realWalter05/automated_chess/docs/latex/images/sachyVzhled.jpg

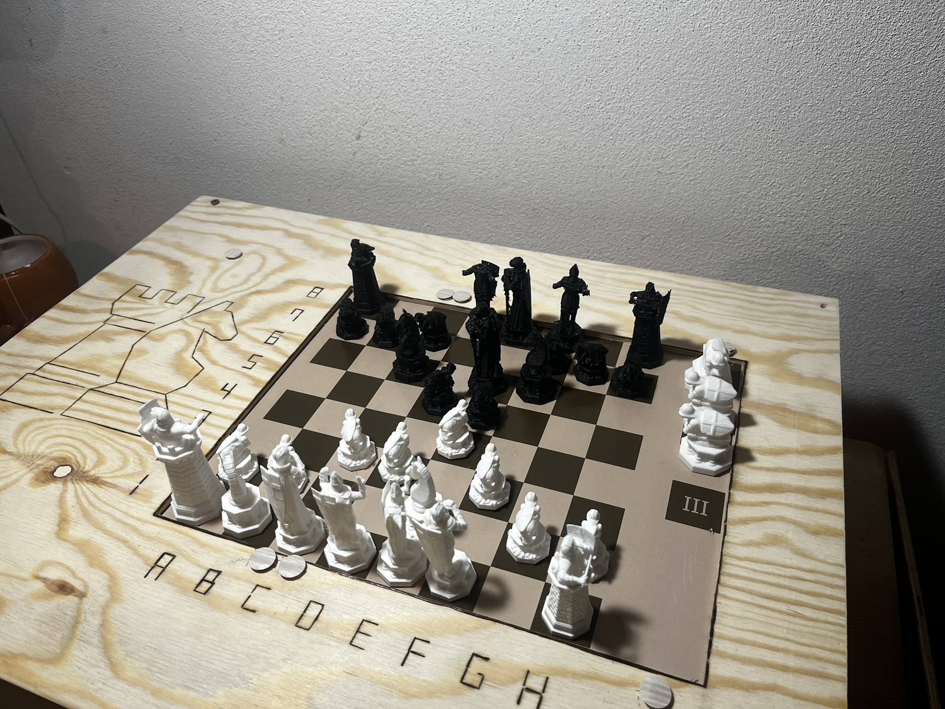
docs/latex/images/sachyVzhled.jpg
