realWalter05/automated_chess/docs/latex/images/pcbDesky.jpg

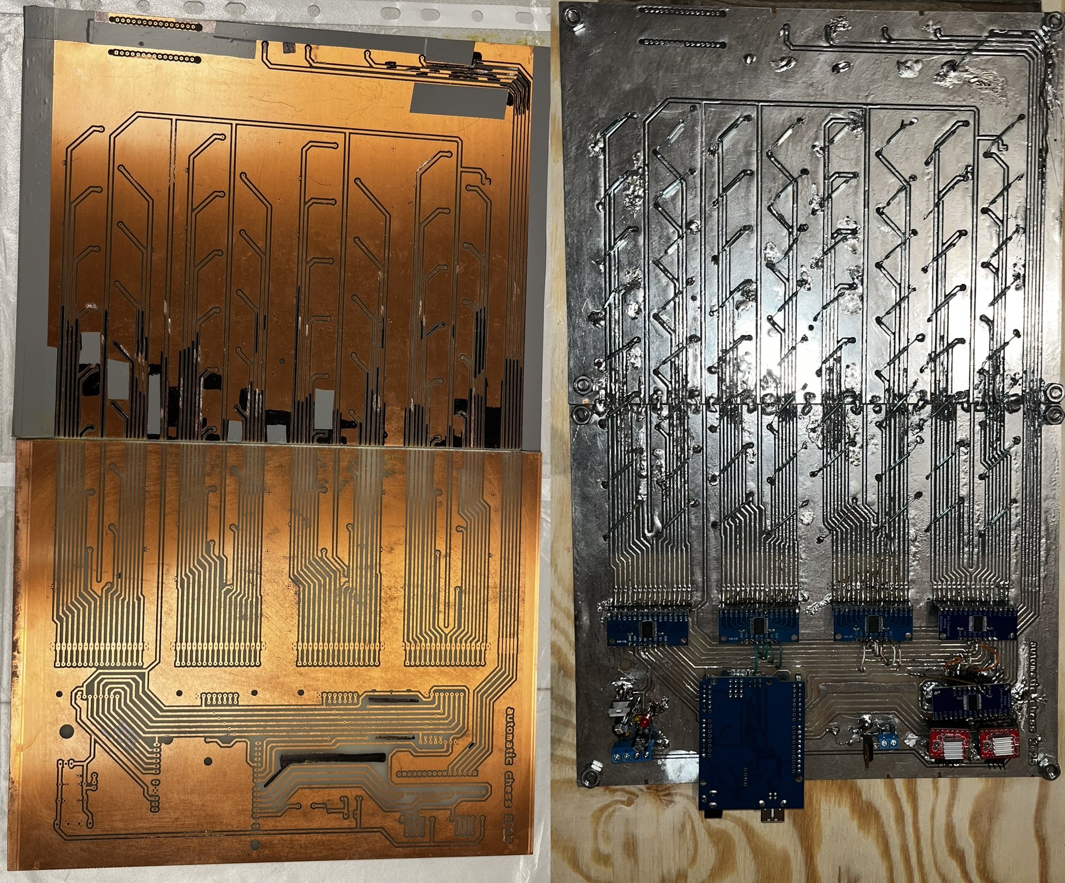
docs/latex/images/pcbDesky.jpg
