realWalter05/automated_chess/docs/latex/document.tex

\documentclass[a4paper, 12pt]{report}
\usepackage{monapack}
\usepackage{xcolor}
\usepackage{listings}

\definecolor{mGreen}{rgb}{0,0.6,0}
\definecolor{mGray}{rgb}{0.5,0.5,0.5}
\definecolor{mPurple}{rgb}{0.58,0,0.82}
\definecolor{backgroundColour}{rgb}{0.95,0.95,0.92}

\lstdefinestyle{CStyle}{
	backgroundcolor=\color{backgroundColour},   
	commentstyle=\color{mGreen},
	keywordstyle=\color{magenta},
	numberstyle=\tiny\color{mGray},
	stringstyle=\color{mPurple},
	basicstyle=\footnotesize,
	breakatwhitespace=false,         
	breaklines=true,                 
	captionpos=b,                    
	keepspaces=true,                 
	numbers=left,                    
	numbersep=5pt,                  
	showspaces=false,                
	showstringspaces=false,
	showtabs=false,                 
	tabsize=2,
	language=C
}

\student{Václav Zíka}
\trida{B4.I}
\obor{18-20-M/01 Informační technologie}
\bydliste{Na Spravedlnosti 974/36, Písek 39701, Česká republika}
\datumNarozeni{29. 12. 2005}
\vedouci{Mgr. Milan Janoušek}
\nazevPrace{Elektromechanická hra -> samořídící\,šachovnice}
\cisloPrace{4.}
\skolniRok{2024/2025}
\reditel{Ing. Jiří Uhlík}

\zacatek

\titulniStrana

\licencniSmlouva{31. 3. 2025}

\anotace 
Maturitní práce se zabývala tvorbou samořídící šachovnice, jejíž cílem bylo kompletně simulovat protihráče.
Ať už se jedná o vymýšlení protitahu či o samotný manuální posun figurky. Šachovnice je ovládána mikrokontrolérem
Arduino~UNO. Pomocí magnetických spínačů umístěných na PCB detekujeme pozici figurek na hracím poli. Tyto informace
následně zpracováváme Arduinem a skrze dva krokové motory a elektromagnet realizujeme tahy figurek. Pro zjištění
ideálního příštího tahu využíváme MiniMax algoritmus, jenž je schopný zevaluovat danou situaci a skrze programovou
logiku udat příkazy pro pohyb figurek. Celá samořídící šachovnice je vyrobena z dřevěné konstrukce, do které je
umístěna deska plošného spoje s elektronikou. Šachové figurky použité v projektu jsou vytvořené pomocí 3D tisku.  \\
\tucne{Klíčová slova:} Samořídící šachovnice, automatizace, programové řízení

\annotation
Graduation thesis focuses on construction of self-controlling chessbord. The goal of the work is to completely simulate opponent. within the simulation, we should be able to come up with ideal counter move and manual movement of the piece. The chessboard is controlled by a microcontroller Arduino UNO. We use reed switches situated on a PCB to detect position of chess pieces. These information we proccess with Arduino and through two stepper motors and an electromagnet we realize moves. To detect ideal next move we use MiniMax algorithm, which is able to evaluate given situation and through program logic set signals for stepper motors. The self-controlling chessboard is made out of wooden construction inside which is installed printed circuit board with neccessary electronics. Chess pieces used in project have been made by 3D print. \\
\tucne{Key words:} Self-controlling chessboard, automatization, program control

\podekovani
Chtěl bych poděkovat panu Mgr. Janouškovi za podporu a vedení práce. Za jeho odborné rady a konzultace ohledně možných řešení. Také bych chtěl vyjádřit dík panu Táborovi, Kutilovi, Kolpovi a panu Vondrákovi.

\obsah

\kapitola{Úvod}
Nápad pro automatickou šachovnici jsem dostal při hledání nového projektu,
který bych si doma zvládl sestrojit. Chtěl jsem, aby projekt obsahoval, jak 
část softwarovou, kterou jsem se do té doby primárně zabýval, tak i část 
mechanickou, kterou by bylo nutné vyrobit. 

Napadlo mě vytvořit nějakou deskovou hru pro více hračů. V té době jsem měl
ve velké oblibě šachy, a proto vznikla idea automatické šachovnice. Začal jsem nákresem
na papír a tím jsem získal základní představu o projektu. Šachovnice by se skládala ze tří
hlavních částí:

\popisseznam{
	\polozka {Konstrukční část} {
		Konstrukční část se skládá ze samotné dřevěné konstrukce šachovnice, do které bude nutné umístít mechanismus
		pro pohybování s figurkami. V rámci toho také její opracování a  nadesignování projektu. 
		Tvorba šachových políček a rozhraní pro jednoduché ovládání.
	}
	\polozka {Elektrotechnická část}{
		Ta obsahuje systém pro detekci figurek na šachovnici. Ten by se dal vytvořit pomocí mnoha
		způsobů, ale v práci budu popisovat řešení pomocí desky plošného spoje. Dále vytvoření pohybové 
		soustavy pomocí krokových motorů a umístění elektromagnetu, který bude s figurkami pohybovat. Posledním
		krokem je sestrojení systému, který dovolí hráči nastavit jakou obtížnost bude mít oponent.
	}
	\polozka {Softwarová část}{
		Z hlediska softwaru je nutné vytvořit kód, který spojí všechny části dohromady. Je nutné transformovat
		signály tak, aby s nimi bylo možné pracovat. Z hlediska kódu je nutné vytvořit rozhraní pro komunikaci
		mezi mikrokontrolérem a součástkami. Je zapotřebí umožnit evaluaci dat o pozicích figurek a předat je
		algoritmu, který nám bude schopen vymyslet další tah. 
	}
}

\kapitola{Teoretická část}
V této kapitole si popíšeme technologie, které byly zapotřebí při tvorbě projektu.
Získáme k nim teoretický základ nutný k porozumění šachovnice.

\podkapitola{Arduino}
Arduino je platforma pro tvorbu různých elektronických projektů. Zabývá se 
hardwarem a softwarem a obě tyto části vytváří jako open-source. To je jeden
z důvodů velkého rozšíření mikrokontrolerů Arduino. 

Mikrokontrolér Arduino je malý počítač založen na jednom čipu. Arduino vyrábí
mnoho různých řad jejich projektů, ale mezi nejznámější se řadí Arduino UNO či
Mega. Arduino desky na sobě mají široké spektrum možných vstupů, výstupů a senzorů.
Velkou výhodou těchto desek je cena. Ta se pohybuje v řádech stovek korun.

Arduino desky se primárně programují pomocí platformy Arduino IDE. To je další open-source
program, který má na základě popularity mezi lidmi i velkou podporu knihoven
s různými zaměřeními.

\podkapitola{Deska plošného spoje}
PCB deska, jak je zkratkou nazývána, nebo také DPS je velmi rozšířená elektronická součástka.
Desky jsou vyrobené z izolačních materiálů s pájecími poli, kterým se říká podložky a elektrickými spoji nazývanými stopy.
Na PCB desky se připájí potřebné součástky. Tyto součástky jsou spolu pak propojeny na základě schématu pro tvorbu PCB. Jsou dvě primární technologie 
montáže součástek na desku. Je tady technologie průchozích otvorů (THT, Through-Hole Technology), nebo povrchové montáže (SMD, Surface-Mounted Devices) \viz{pcb_SMT_THT}. Při povrchové montáži se napájí součástky přímo na desku s tím, že jsou na ní připravené jednotlivé stopy. U THT jsou v desce připravené otvory, do kterých součástky umísťujeme.
\obrazek{pcb_SMT_THT}{Rozlišení SMT a THT na PCB desce}{12cm}{pcb_SMT_THT.png} 

\podkapitola{Elektronické součástky}
\podpodkapitola{Magnetický spínač}
Tento typ spínače je elektronický obvod aktivovaný pomocí magntického pole. Nejběžnější je konstrukce pomocí dvou feromagnetických kovů umístěných kousek od sebe ve skleněné kapsli. V momentě, kdy je ke spínači přiložen magnet se kovy spojí a začnou vodit. Magnetické spínače jsou například využívány pro detekci uzavření dveří. 

\podpodkapitola{Multiplexor}
Tato elektronická součástka slouží k přepínání vstupů na jeden výstup na základě řídících signálů. Multiplexor je realizován integrovanými obvody. Pomocí této součástky jsme napřílad schopni zvětšit počet vstupů na určitém zařízení o počet vstupů na multiplexoru, s tím že do zařízení zapojíme pouze multiplexor. Tento postup je ideální v momentě, kdy máme zařízení s nedostatkem vstupů pro dané využití.

\podpodkapitola{Stabilizátor}
Stabilizátor nám zajištuje výstupní nápětí bez ohledu na změny výstupního proudu či vstupního napětí. Stabilázátory se dělí na lineární paremetrický, lineární zpětnovazební a spínací zpětnovazební. Stabilizátory fungují na principu regulace odporu pomocí tranzistoru na základě referečního napětí a napětí žádaného. Ke stabilizátoru se přidávají kondenzátory, které eliminují šum a stabilizují výstup. Lineární stabilizátory regulují napětí, tím že fungují jako proměnný odpor mezi vstupem a výstupem. 

\podpodkapitola{Elektromagnet}
Elektromagnetem se rozumí cívka pomocí, které jsme schopni vytvořit dočasné magnetické pole. Jádro této cívky je z magneticky měkké oceli. V momentě, kdy začneme cívkou vést proud, začne se okolo ní vytvářet magnetické pole. Velikost a polaritu tohoto pole jsme schopni ovládat.

\podpodkapitola{Krokový motor}
Krokový motor je zařízení, které nám dovolí na základě elektromagnetických pulsů přesně rotovat. V motoru je ozubené kolo, které můžeme otáčet na základě polových dvojic. Pomocí pulsování jednotlivá pole přitáhnou ozubené kolo a na základě tohoto jevu, můžeme motor otočit o přesný počet kroků. Rychlost rotování jsme schopni korigovat na základě změn frekvence aktivace polí. To realizujeme skrze ovladače krokových motorů.

\podkapitola{Mini-Max algoritmus}
Tento typ algorithmu je fundamentálním konceptem umělé inteligence a teorie her. Mini-Max má za cíl zminimalizovat možnou ztrátu na základě analýzy nejhorších možných scénářů, neboli min, a těch nejlepších, max. Ve hře pro dva hráče si algoritmus vytvoří dvě interní entity. Ta první se jmenuje Maximizer a cílí získat nejvyšší možné skóre. Oproti ní druhá, Minimizer, má za cíl, co nejvíce skóre Maximizer snížit. Toho docílí tak, že evaluuje všechny možné tahy obou hráčů zároveň.\clearpage\obrazek{minimax}{Minimax algoritmus}{10cm}{minimax.png}

Z počátku si Mini-Max vytvoří tzv. herní strom. Účelem tohoto stromu je reprezentovat všechny možné tahy, které mohou v daný moment ve hře nastat. Dalším krokem je, že u tzv. závěrečných stavů (terminal nodes) určí skóre. Skoŕe se určuje na základě kritérií daných v kódu a postupně ve stromu postupuje výše a určuje skóre dál. Poté, co Mini-Max určí skóre pro všechny možné stavy, projde jednotlivé scénáře. V kole Maximizera volí variantu s nejvyšším možným skórem. Naopak v kole minimizera tu s nejnižším. Podle nejvyššího možného celkového skóre algoritmus určí příští zvolený blok.

\kapitola{Praktická část}

\podkapitola{Elektrické zapojení}
Pro projekt bylo zapotřebí vymyslet efektivní a spolehlivý způsob propojení. Zároveň však způsob nesměl bránit detekci figurek pomocí spínačů. Nabízela se spoustu možností, ale z důvodů velkého množství součástek jsem se rozhodl pro dle mě nejčistčí řešení, a to desku plošného spoje. 

\podpodkapitola{PCB deska}
Deska plošného spoje bylo řešením, které se nabízelo kvůli spolehlivosti a zároveň tím, že deska je velmi tenká  a její materiál nijak nebrání průchodu magnetického pole. Na základě mého schématu v programu EasyADA jsem si desku nechal sestrojit. Schéma šachovnice najdete v přílohách pod názvem schema\_sachovnice.pdf. Z důvodu výrobních možností a rozměrů desky byla deska sestrojena na dvě poloviny. Tyto poloviny jsem spájel dohromady. Deska byla vyrobena technologií SMT, takže jsem na ní povrchově připájel piny pro všechny potřebné součástky. A to:
\bodseznam{
	\bod 69 jazýčkových magnetických kontaktů
	\bod 5 analogových multiplexorů, transistor a různé drobné zařízení
	\bod Mikrokontroler Arduino UNO
	\bod Dva A4988 ovladače pro krokové motory
	\bod Stabilizátor a piny pro vstupní napětí
	\bod Napájení pro motory a elektromagnety
}
\clearpage\obrazek{pcb_porovnani}{Porovnání PCB desky z výroby a osázené}{16cm}{pcbDesky.jpg}
Desku jsem si následně nechal pocínovat. Dvě části jsem pomocí propojek spojil dohromady. Během práce jsem posléze při detekci figurek musel řešit velký problém, a to se spolehlivostí desky. Magnetické spínače nefungovaly spolehlivě. Důvodem byly narušené cesty a také křekhost spínačů. Ty během pájení velmi snadno praskly.

Tyto problémy jsem řešil za pomocí multimetru a posléze detekcí pomocí počítače. Na desce jsem postupně zkontroloval všechny cesty a v momentě, kdy špatně vodily jsem na ně napájel vrstvu cínu. Pokud problém spočíval v propojení dvou vedlejších cest, vzal jsem nůž a cín manuálně odstranil. Největším úśkalím bylo manuální propojení dvou desek dohromady. Tato část desky vyžadovala časově velmi úpornou manuální péči.

Desky se mi po opravách podařilo dostat do spolehlivého stavu. Jednou věcí, která mi však projekt stížila bylo, že nespolehlivost cest na desce a spínačů jsem objevil až v momentě, kdy jsem programoval detekci figurek. V tuto chvíli jsem však již, alespoň mohl využít napojení na multiplexory a pomocí kódu je kontrolovat skrze konzoly na počítači. To usnadilo proces oprav.

Deska je napájena externím 18V zdrojem. Na desce se pomocí stabilizátoru pro většinu součástek nastaví napětí 5V, avšak pro motory a elektromagnet zůstává napětí 18V.

\podpodkapitola{Výběr řídící jednotky}
Mikrokontrolér, který jsem si vybral pro samořídící šachovnici je Arduino UNO. Toto Arduino splňovalo veškeré nutné požadavky pro ovládání a zároveň to byl mikrokontroler, který jsem měl z počátku projektu doma a mohl jsem na něm zprvu testovat. Arduino je napájeno 5V z PCB desky a ovládá celou šachovnici. Arduino je naprogramováno variantou jazyku C++, ale o tom budu psát podrobněji později v práci. Do mikrokontroleru jsou skrze multiplexory zapojeny všechny magnetické spínače. Arduino si pomocí programové logiky přepíná jaký z multiplexorů bude v dané chvíli aktivní, jelikož data multiplexorů proudí po stejných cestách. Dále jsou do Arduina zapojené drivery motorů a transistor, který slouží k ovládání elektromagnetu.

\podkapitola{Detekce obsazenosti políček}	
V této kapitole popíši, na jakém principu se v šachovnici detekují pozice figurek. Vysvětlím jednotlivé zapojení multiplexorů a kód, který je ovládá. Spolehlivé detekování pozice figurek je stěžejním bodem této práce, jelikož z něho vychází další operace projektu.

\podpodkapitola{Zapojení a princip}
Aby samořídící šachovnice fungovala je zapotřebí vědět pozici figurek na herním poli. Nabízí se dvě řešení. Detekce pomocí kamer a zpracování obrazu a pomocí magnetických spínačů. Řešení pomocí kamer jsem zavrhl, jelikož by to znamenalo nějaké rameno na šachovnici s kamerou. To mi nepřipadalo ideální. Magnetické spínače nám zachovají čistý vzhled šachovnice. Jelikož však na šachovnici máme 64 políček, potřebujeme 64 spínačů. Tolika piny naše Arduino Uno nedisponuje, a tak je zapotřebí využít nějaký systém pomocí, kterého počet vstupů snížíme. 

Po průzkumu a práci na řešení jsem se inspiroval z jednoho projektu dostupného na internetu \citace{Projekt automatické šachovnice}. V tomto projektu bylo využito multiplexorové řešení. Zapojíme piny spínačů do multiplexoru, a ten pak čteme pomocí řídící jednotky. Pomocí tohoto postupu jsme schopni zredukovat 64 pinů na 4 multiplexory. V této práci jsem jich využil pět, jelikož poslední multiplexor se stará o volbu obtížností a barvy.
\clearpage\obrazek{spinaceSchema}{Zapojení magnetických spínačů na desce}{16cm}{spinaceSachovnice.png} 

Multiplexory, které jsem využil mají 16 datových vstupů, 4 vstupy adresové, nápajení, zem, zapínací pin EN a výstup SIG. Výstupy multiplexorů, jak je vidět na schématu \viz{spinaceSchema}, jsou zapojeny do stejných cest na PCB desce. Stejně tak výstup SIG je pro všechny multiplexory stejný. Toto není problém, jelikož v kódu využivám pin Enable (en). Jestliže je tento pin v logické jedničce, je multiplexor vypnutý. V momentě, kdy je v logické nule, je zapnutý. Na základě tohoto principu jsme schopni přepínat přepínače samotné a tím ještě více zminimalizovat počet nutných vstupů do Arduina UNO.

\podpodkapitola{Programový kód}
Jak už jsme zmínili, šachovnice je ovládána mikrokontrolerem Arduino UNO, jenž se programuje variantou C++. Kód pro ovládání multiplexorů nám musí zajistit jejich přepínání pomocí Enable pin a stabilní detekci pozic. První věc, kterou musíme v kódu nastavit jsou Enable piny. Po zapnutí nastavím Enable pin jako OUTPUT a pomocí for loopu si procyklujeme všechny Enable piny multiplexorů a dáme na ně logickou jedničku. Tato část kódu je v setup() funkci kódu. Ta se spustí pouze po spuštění mikrokontroleru.
\begin{lstlisting}[style=CStyle]
// Disabling Multiplexers  (When high - does nothing)
for (int i = 0; i < 5; i++) {
	pinMode(muxEnable[i], OUTPUT);
	digitalWrite(muxEnable[i], HIGH);
}

for (int i = 0; i < 4; i++) {
	pinMode(muxAddr[i], OUTPUT);
	digitalWrite(muxAddr[i], LOW);
}
\end{lstlisting}

\podpodpodkapitola{Čtení hodnot pomocí getReedValues()}
Pro čtení hodnot využíváme funkci getReedValues. V ní nejprve zaktivujeme multiplexor tím, že mu nastavíme pin na 0. Poté začneme na jeho adresové piny vysílat binarní kombinace od 0 do 15. Toho docíleme opět pomocí for cyklu a využití modulo funkce (v kódu jako \%). Data následně ukládáme do našeho interního variablu muxValues a poté, co deaktivujeme multiplexor a jeho adresové vstupy, překopírujeme pomocí funkce memcpy hodnoty do proměnné recordedReedValue. Ta nám slouží pouze pro ukládání nejnovější možné detekce pozic. Pozice každé druhé řady zapisujeme oproti řadě první obráceně. To je z důvodu zapojení na PCB desce a realizováno podmínkou ve funkci.

\begin{lstlisting}[style=CStyle]
void getReedValues(int targetMuxAddress, int from, int to) {
	// Splitting to two rows because row of chessboard has 8 pieces
	int muxValues[8];
	
	// Activating MUX
	digitalWrite(targetMuxAddress, LOW);
	for (int j = from; j < to; j++) {
		// Checking MUX combinations
		digitalWrite(muxAddr[0], j % 2);
		digitalWrite(muxAddr[1], j / 2 % 2);
		digitalWrite(muxAddr[2], j / 4 % 2);
		digitalWrite(muxAddr[3], j / 8 % 2);
		
		int reedValue = digitalRead(muxOutput);
		
		if (j > 7) {
			muxValues[j - 8] = reedValue;
		} else {
			muxValues[to - j - 1] = reedValue;
		}
	}
	// Resetting MUX
	digitalWrite(muxAddr[0], LOW);
	digitalWrite(muxAddr[1], LOW);
	digitalWrite(muxAddr[2], LOW);
	digitalWrite(muxAddr[3], LOW);
	
	digitalWrite(targetMuxAddress, HIGH);
	memcpy(recordedReedValue, muxValues, sizeof(recordedReedValue));
}
\end{lstlisting}

Jelikož je SIG pin multiplexorů nastavený jako INPUT\_PULLUP, což je nutné pro detekci zda spínač spíná zem či je rozpojený, dostávám všechny rozpojené spínače jako jedničky. Ty seplé jako nuly. Ve výsledku může výstup v konzoli po zahájení hry vypadat takto.
\clearpage
\begin{center}
\strojopis{\\
8 - 0 0 0 0 0 0 0 0\\
7 - 0 0 0 0 0 0 0 0\\
6 - 1 1 1 1 1 1 1 1\\
5 - 1 1 1 1 1 1 1 1\\
4 - 1 1 1 1 1 1 1 1\\
3 - 1 1 1 1 1 1 1 1\\
2 - 0 0 0 0 0 0 0 0\\
1 - 0 0 0 0 0 0 0 0\\
-------A B C D E F G H
}
\end{center}

\podpodpodkapitola{Ukládání všech pozic}
Předchozí funkce nám zajištuje přečtení hodnot multiplexoru na základě daných parametrů. V kódu máme další pomocnou funkci setCurrentBoard(). Cílem této funkce je projít všechny řady šachovnice od první až po osmou a uložit je do mikrokontroleru. V mikrokontroleru je opět pomocí funkce memcpy překopíruje do dvouřadého listu boardValues, který obsahuje všechny pozice figurek.
\begin{lstlisting}[style=CStyle]
void setCurrentBoard() {
	getReedValues(muxEnable[0], 0, 8);
	memcpy(boardValues[0], recordedReedValue, sizeof(boardValues[0]));
	
	getReedValues(muxEnable[0], 8, 16);
	memcpy(boardValues[1], recordedReedValue, sizeof(boardValues[1]));
	//.....another five reads
	getReedValues(muxEnable[3], 8, 16);
	memcpy(boardValues[7], recordedReedValue, sizeof(boardValues[7]));
\end{lstlisting}

\podpodpodkapitola{Detekce přemístění figurek}
Předchozí funkce v této kapitole nám vysvětlují, jak šachovnice data čte. Nadcházející funkce je však zodpovědná za samotnou detekci změny pozic, při kterých uživatel vezme figurku do ruky a přendá ji na jiné políčko. Tato funkce je napsána bloku loop(). To je opět platformou Arduino daná funkce, která se po spuštění již zmíněné funkce setup() neustále opakuje.

Abychom zjistili, zda se událo přemístění figurky musíme pravidelně číst pozice hodnot a porovnávat je z přechozími. To děláme pomocí while cyklu, který se opakuje do doby, než jsou splněné podmínky uvedené v závorkách. Podmínky, které jsou v kódu nastavené vyžadují, aby list proměnných move obsahoval čtyři hodnoty. Neboli hodnotu čísla a písmena odkud se figurka přemístila a hodnoty kam. Jak zjistíme hodnoty, které ukládáme do move, vysvětlím dále v textu. Nejprve tedy uložíme hodnoty pozic do proměnné boardValuesMemory a následně přejdeme do cyklu. V tomto cyklu se neustále volá funkce detectBoardMovement() až do splnění zmíněných podmínek.
\begin{lstlisting}[style=CStyle]
	// Player's turn => waiting for movement
	setCurrentBoard();
	memcpy(boardValuesMemory, boardValues, sizeof(boardValuesMemory));
	while (!move[0] || !move[1] || !move[2] || !move[3]) {
		detectBoardMovement();
	}
\end{lstlisting}

\podpodpodkapitola{Funkce detectBoardMovement()}
Pomocí této funkce detekujeme, zda bylo uskutečněno přemístění figurek. Tato funkce je volána cyklicky z while loopu dokud nenajdeme čtyři hodnoty pro proměnnou move. Např. e2e4 by nám značilo pohyb z počátku hry pěšče o dvě místa z e2 na políčko e4. Funkce porovnává současné hodnoty pozic v proměnné boardValues, které nastaví pomocí funkce setCurrentBoard() s hodnoty boardValuesMemory  uloženými v hlavním cyklu před zahájením while cyklu. 

\begin{lstlisting}[style=CStyle]
void detectBoardMovement() {
	bool fromChange = false;
	setCurrentBoard();

	for (int i = 0; i < 8; i++) {
		for (int j = 0; j < 8; j++) {
			if (boardValuesMemory[i][j] != boardValues[i][j] && boardValues[i][j]) {
				// Position of piece has changed
				delay(1000);
				setCurrentBoard();
				if (boardValues[i][j]) {
					// Piece was here before
					fromChange = true;
					move[0] = letterTranslate[j];
					move[1] = numberTranslate[i];
				}
			}
		}
	}

	// For loop for 1-0...

	if (!fromChange || (move[2] && !move[0])) {
		setCurrentBoard();
		memcpy(boardValuesMemory, boardValues, sizeof(boardValuesMemory));
		resetMove();
	}
	delay(1000);
}
\end{lstlisting}
Funkce pomocí for loopu prochází hodnoty pozic a tam postupně porovnává každé políčko s každým dokud nenajde nějakou změnu. V případě, že všechny hodnoty jsou stejné jako předtím, funkce se s vteřinovým zpožděním spustí znovu. V případě změny však pomocí kódu detekujeme zda šlo o změnu z 0 na 1 či naopak. 

\popisseznam{
	\polozka {Změny z 0 na 1}{Jelikož logická jednička označuje prázdné políčko, tato zmena značí odkud se figurka přemístila. Zapíše se tedy do move na první a druhé pozici.}
	\polozka {Změny z 1 na 0}{Značí, že políčko bylo dříve prázdné a nyní se na něj umístila nová figurka. Zapíše se tedy do list move na třetí a čtvrtou pozici}
}

V momentě, kdy naplníme všechny čtyři místa v listu move, zruší se while cyklus v hlavní funkci programu a kód může postupovat dále. Ve funkci na konci kontrolujeme situaci, kdy se projde celý cyklus a najde pouze pozici, kam se figurka přemístila ale ne odkud. Také hlídáme situaci, kdy se žadný tah nenajde. V takových případech, tah resetujeme a nastavíme novou hodnotu pozic spínačů do boardValuesMemory. Poté je ve funkci vteřinové zpoždění, které zajištuje větší spolehlivost detekce při přesunu figurek.

\podkapitola{Pohyb figurek na hracím poli}
Realizaci šachových tahů nám zajištují dva krokové motory a elektromagnet. Pro účel práce bylo nutné umožnit XY pohyb elektromagnetu uvnitř šachovnice. Soustavu bylo nutné umístit dovnitř konstrukce a zajistit, aby byl elektromagnet velmi blízko PCB desce a tím i figurkám.

\podpodkapitola{Elektromagnet}
Samotné přemístění figurky je realizováno pomocí elektromagnetu. Ten po přivedení proudu vytvoří elektromagnetické pole, které začne působit na magnetickou šachovou figurku nad ním, a tím s ní můžeme hýbat. Během tvorby řešení jsem musel zajistit, aby elektromagnetické pole nebylo příliš velké a neovlivňovalo ostatní figurky. Zprvu ovšem nastal jiný problém. Elektromagnet, i když zapnutý, nebyl schopen figurkou pohnout. Tato situace nastala na základě faktu, že pro velkou účinost elektromagnetu je nutné zminimalizovat prostor mezi elektromagnetem a přitahovaným tělesem. V situaci, kdy jsem používal elektromagnet se silou 150N stále to nebylo dostatečné. Problém jsem vyřešil vyvýšením elektromagnetu v konstrukci a zasazením jej blíže k plošnému spoji. Po těchto úpravách mi postačil, elektromagnet se silou 50N. Avšak ani tento elektromagnet by s figurkami nepohnul, jestliže by do nich nebyly umístěné magnetické prvky. Pokud bu do figurky byla umístěna prostá ocel, nedokázal by jí elektromagnet přemístit.

Elektromagnet, který v práci využívám je v paremetrech u prodejce uváděn na 12V. Já do něj však vysílám 18V z důvodu lepší spolehlivosti. Abychom však elektromagnet mohli ovládat, musel jsem vymyslet způsob, jakým do elektromagnetu těchto 18V budu vpouštět pouze po zaslání signálů. Na to využivám transistor. Transistor použitý v práci po přivedení signálu na bázi, přepne vstup z kolektoru na emitor. Na kolektoru mám přivedenou zem a po zaslání signálů na bázi, vyšlu zem skrze emitor do elektromagnetu. Ten je z jeho druhého vstupu připojen k napětí a po přivedení země, začne působit. Po ukončení signálu na bázi se elektromagnet vypne.\obrazek{transistor}{Ovládání elektromagnetu pomocí transistoru}{8cm}{transistor.png} 

Kód, který transistor ovládá je velmi jednoduchý. Ve fuknci makeMove, o které budu v dalších kapitolách hovořit, je boolovská proměnná magnetActivated. V případě, že magnet potřebuji, nastavím jí jako true a pomocí podmínky v této funkci vyšlu na pin báze transistoru (magnetPin) logickou jedničku. Na konci funkce  po provedení pohyby, magnet vždy vypínám.
\begin{lstlisting}[style=CStyle]
	// Enabling the electromagnet if neccesary
	if (magnetActivated) {
		digitalWrite(magnetPin, HIGH);
	}
\end{lstlisting}

Dále je důležitá kalibrace elektromagnetu. Pro správný průběh programu je zapotřebí, aby elektromagnet byl vždy na začátku hry na stejném místě. Toto místo je mírně vedle pozici a1. Ke kalibraci využíváme funkci resetMagnet a setupMagnet. Přemístění provedeme, tak že po zapnutí samořídící šachovnice, umístíme na pozice ovládacích spínačů tři figury. Obsadíme pozice pro volbu hry za bílé, černé a první obtížnost.

\begin{lstlisting}[style=CStyle]
while (!controlValues[4] && !controlValues[5] && !controlValues[6]) {
	getReedValues(muxEnable[4], 0, 8);
	memcpy(controlValues, recordedReedValue, sizeof(controlValues));
	digitalWrite(dirPinX, LOW);	
	digitalWrite(stepPinX, HIGH);
	delayMicroseconds(motorDelay + 600);
	digitalWrite(stepPinX, LOW);
	delayMicroseconds(motorDelay + 600);
	magnetX = 1;
}
\end{lstlisting}

Kód začne přesouvat elektromagnet doleva až do doby, kdy odstraníme figury ze spínače pro obtížnost. Poté se začne elektromagnet přesouvat směrem dolů. Cílovou pozici poznáme pomocí zvuku, které motory při pohybu dodávájí. V momentě, kdy magnet dosáhne cílové ať už X či Y souřadnice, začne zvuk motoru zintenzivňovat. Elektromagnet eventuálně pomocí funkce setupMagnet, posuneme mírně směrem vpravo a tím zajistíme start na pozici a1.

\podpodkapitola{Krokové motory}
Pro zajištění pohybu využívám dva krokové motory NEMA17 s driverem A4988. Driver krokových motorů slouží jako mezikrok mezi programem a kódem a zajištuje pohodlné ovládání motorů. Do těchto driverů přivádím po desce, jak 18V, tak 5V. Dále na nich nastavujeme směr pohybu a vysíláme signály, pomocí kterých pak motor hýbe s konstrukcí. Pro zajištění správného pohybu bylo nutné zajistit dostačné napětí. To je dle specifikací 8 až 35V. Po otestovaní jsem zjistil, že 18V bylo pro projekt ideální. Abych zamezil přehřívání ovladačů, nalepil jsem na ně z vrchu chlazení, které je s nimi prodáváno.

\podpodpodkapitola{Konstrukce}
Konstrukce je realizována pomocí soustavy dvou motorů. Během řešení této problematiky jsem se inspiroval tímto projektem\citace{Projekt řízené šachovnice}. První motor je umístěn zevnitř boční stěny šachovnice. Na motor jsem umístil vhodnou řemenici a řemen natáhl na protější stěnu. Zde jsem si ze dřeva sestrojil ústrojí pro další řemenici. Pod řemenem vedou tři vodicí tyče, do kterých jsem umístil druhý motor s konstrukcí. Řemen prochází touto konstrukcí a při otáčení řemenice, tak pomocí řemenu pohybujeme na Y ose i s konstrukcí uvnitř šachovnice. Vnitřní konstrukce je umístěna na třech ložiscích, kterými prochází vodící tyčí. V této vnitřní dřevěné konstrukci je vyříznut otvor pro druhý krokový motor a zde je postupováno podle podobného postupu. Vedou zde dvě vodicí tyče na X ose. Na těchto vodicích tyčí jsou dvě ložiska, na která jsem si sestrojil dřevěnou plošinku připravenou pro umístění magnetu. Magnet je na plošině vyvýšen pro zajištění spolehlivého přenosu figurek a kabely jsou vyvedeny na PCB desku. Na druhé straně je opět ústrojí pro řemenice a řemen je proveden skrze plošinu s elektromagnetem.\clearpage\obrazek{konstrukceKrokovychMotoru}{Konstrukce krokových motorů}{14cm}{krokoveMotory.png} 

\podpodpodkapitola{Programový kód}
Funkci, která ovládá motory jsem nazval moveMagnet. Tato funkce bere tři vstupní parametry. Směr (direction) a vzdálenost (distance). Pro přehlednost nerozlišuje směry pomocí if podmínek, ale pomocí switche. V něm nastavím, jaký blok kódu se provede, jestliže směr bude odpovídat hodnotě za "case". Hodnota směru je dána jako pozice v numerické klávesnici. Tedy 4 jako pohyb vlevo, 2 pohyb směrem dolů a např. 9 jako diagonální pohyb doprava nahoru.
\begin{lstlisting}[style=CStyle]
void moveMagnet(int direction, int distance) {
	switch (direction) {
		//...
		case 4:
			// Left
			digitalWrite(dirPinX, LOW);
			for (int i = 0; i < boxLength * distance; i++) {
				digitalWrite(stepPinX, HIGH);
				delayMicroseconds(motorDelay);
				digitalWrite(stepPinX, LOW);
				delayMicroseconds(motorDelay);
			}
			magnetX = magnetX - distance;
		break;
		case 9:
			// Diagonal right up
			digitalWrite(dirPinY, HIGH);
			digitalWrite(dirPinX, HIGH);
			for (int i = 0; i < boxLength * distance; i++) {
				digitalWrite(stepPinY, HIGH);
				digitalWrite(stepPinX, HIGH);
				delayMicroseconds(motorDelay);
				digitalWrite(stepPinY, LOW);
				digitalWrite(stepPinX, LOW);
				delayMicroseconds(motorDelay);
			}
			magnetX = magnetX + distance;
			magnetY = magnetY + distance;
		break;
	}
//...
\end{lstlisting}
Samotný kód, který vysílá signály ovladači je v bloku pod case. Nejprve určíme směr pohybu. Buď logickou nulou či jedničkou. Následně začneme pomocí for cyklu vysílat pulzy do motoru. Vždy nejdříve aktivujeme nutný stepPin. Pak zahájíme prodlevu. Tato prodleva nám určuje rychlost otáčení. Čím menší je, tím rychleji se motory točí. Poté stepPin vypneme a znovu zahajíme prodlevu. Tento cyklus se opakuje podle žádané vzdálenosti, kterou násobím délkou jednoho políčka.

\podpodpodkapitola{Realizace tahu dle souřadnic}
Abychom byli schopni zahrát šachový tah musíme ho transformovat do souřadnic. Zde si vysvětlíme funkci, která tah realizuje.

Tato funkce se jmenuje makeMove a bere pět vstupních parametrů, XY souřadnice odkud a kam a dále, zda má být elektromagnet zapnutý. Věc, kterou jsem určil tak, aby se provedla jako první, je diagonální pohyb. Pomocí testování různých vztahů na šachovnici, jsem přišel na vzorec, který nám určuje diagonální pohyb.
\vzorec{|y-targetY| == |targetX-x|}
Jestliže v situaci vztah platí, provedeme diagonální pohyb na místo a ukončíme funkci pomocí return. Ve funkci dále rozlišujeme pohyb diogonální doprava/doleva nahorů či dolů. Jaký potřebujeme zjistíme porovnáním x a targetX. 
\begin{lstlisting}[style=CStyle]
	if (abs(y - targetY) == abs(targetX - x)) {
		// Diagonal movement when moving piece
		if(y > targetY) {
			// Diagonal down
			if (x < targetX) {
				// Right
				moveMagnet(3, targetX - x);
			} else {
				// Left
				moveMagnet(1, targetX - x);
			}
		} else {
			if (x < targetX) {
				// Right
				moveMagnet(9, targetX - x);
			} else {
				// Left
				moveMagnet(7, targetX - x);
			}
		}
		return;
	}
\end{lstlisting}

Pokud pohyb dle souřadnic není diagonální, pohneme s figurkou po X či Y ose. Proces je podobný jako předtím, akorát zde neaplikujeme vzorec ale pouze porovnáváme. Využíváme zde dřívě zmíněnou funkci moveMagnet, kterou dáváme jako požadovanou urazenou vzdálenost rozdílem mezi x a targetX. Nejprve provedeme pohyb vertikální a až poté horizontální.

\begin{lstlisting}[style=CStyle]
// Move magnet to starting position on Y
if (y < targetY) {
	// Move up
	moveMagnet(8, y - targetY);
} else if (y > targetY) {
	// Move down
	moveMagnet(2, targetY - y);
}
\end{lstlisting}

\podpodkapitola{Šachový tah}
Algoritmus, který nám určuje tahy oponenta je udáván v tomto formátu šachovém formátu, např. e2e4. Tento fakt nám komplikuje proces tahu oponenta. Musíme totiž transformovat tento příkaz do příkazu, kterému rozumí krokové motory.

Tuto transformaci provádíme ve funkcni makeChessMove. Ta má jako vstup daný set znaků, který si přeloží do instrukcí. K překladu využíváme C funkcni strchr, které nám udá pozici v listu. K ní pak přičteme jedničku a máme požadovanou X souřadnici tahu. Pro "e" by to tedy bylo 5. Y souřadnici pouze změníme z textu na číslo tím, že od něj odečteme textovou nulu. Následně tyto souřadnice předáme do funkce makeMove, kterou jsme vysvětlili v předchozí kapitole.
\begin{lstlisting}[style=CStyle]
void makeChessMove(char givenMove[5]) {
	char aiLetterTranslate[8] = "abcdefgh";
		
	int fromX = strchr(aiLetterTranslate, givenMove[0])-aiLetterTranslate+1;
	int fromY = givenMove[1] - '0';

	int toX = strchr(aiLetterTranslate, givenMove[2])-aiLetterTranslate+1;
	int toY = givenMove[3] - '0';
	//...
\end{lstlisting}

Po těchto operacích teprve zahajíme požadovaný přesun figurky. Přemístíme magnet z jeho současných souřadnic na souřadnice figurky, s kterou má pohnout a poté, co tam dorazí aktivujeme elektromagnet a přemístíme magnet i s figurou na souřadnice cílové. V momentě, kdy není nutný žádný speciální typ pohybu, realizujeme ho takto.

\begin{lstlisting}[style=CStyle]
  // Other pieces
  makeMove(magnetX, magnetY, fromX, fromY, false);
  makeMove(fromX, fromY, toX, toY, true);
\end{lstlisting}

Přenos na cílové souřadnice musíme dále rozlišit na základě různých situací, které mohou nastat. Šachovnice si musí umět poradit s pohybem koně i v situaci, kdy kůň nemá prostor na pohyb, s rošádou a běžným šachovým pohybem.

\podpodpodkapitola{Pohyb koně}
Ve funkci makeChessMove musíme nějakých způsobem pohyb koně detekovat. V rámci práce jsem postupným testováním přišel na tento vzorec, kterým  pohyb detekujeme.
\vzorec{[fromY - toY]~!=~[toX - fromX] ~~\&\&~~  ([fromX - toX] == 1~||~[fromX - toX] == 2)}

Pohyb koně řeším ve funkci handleHorseMovement. Rozlišuji ho na horizontální a vertikální. O jaký se jedná zjistím opět pomocí absolutní hodnoty. Jestliže je rozdíl počátečního a konečného X rovné 1, jedná se o pohyb vertikální. V případě, že je to 2, tak pohyb horizontální. Horizontální pohyb se vykonává principiálně stejným způsobem jako vertikální, a tak dále popíši pouze ten vertikální.

\begin{lstlisting}[style=CStyle]
if (!isPlaceOccupied(fromX, awayY)) {
	// Empty in front him
	makeMove(fromX, fromY, fromX, awayY, true);
	makeMove(fromX, awayY, toX, toY, true);
	return;
}
\end{lstlisting}

Ve funkci opět kontrolujeme pozice před koněm. V bloku nad tímto textem je kód pro řešení situace, kdy je pole přímo před koněm volné. Pak pouze standartně vyjedeme. V momentě, kdy je jsou volná místa na stranách, přemístěme koně diagonálně do nich a až poté na cílové místo.

Další situací, kterou jsem v práci musel vyřešit je když kůň nemá žádný prostor pro pohyb. Tato situace nastane například pokud chce algoritmus zahrát pohyb koně jako první tah. Jako řešení jsem vytvořil kód, který nejprve uhne s figurkou před koněm, poté přemístí koně a figurku vrátí.

\begin{lstlisting}[style=CStyle]
int awayY = fromY - 1;
int awayPawnY = fromY - 3;
if (fromY < toY) {
	awayY = fromY + 1;
	awayPawnY = fromY + 3;
}
	
if (awayPawnY > 0 && awayPawnY < 9) {
	// Move pawn away
	makeMove(fromX, fromY, fromX, awayY, false);
	makeMove(fromX, awayY, fromX, awayPawnY, true);
	
	// Move horse to place
	makeMove(fromX, awayPawnY, fromX, fromY, false);
	makeMove(fromX, fromY, toX, toY, true);
	
	// Move pawn back to place
	makeMove(toX, toY, fromX, awayPawnY, false);
	makeMove(fromX, awayPawnY, fromX, awayY, true);
}
\end{lstlisting}

Nejprve nastavíme hodnoty awayY a awayPawnY. Away Y nám určuje s jakou figurkou chceme uhýbat a awayPawnY nám udává, kam s ní uhneme. Poté zkontrolujeme, zda pozice, kam chceme figurku blokující pohyb koně přemístit, je v rámci šachového pole. Poté s ní uhneme na pozici awayPawnY. Koně přesuneme na pozici figurky a pak na cílové místo. Figurku z awayPawnY vrátíme na původní pozici.

\podpodpodkapitola{Řošáda}
V šachu mohou nastat pouze 4 různé šachové rošády. V kódu jsem v podmínce tyto situace zadefinoval a kontroluji je při makeChessMove. 

\begin{lstlisting}[style=CStyle]
if (fromX == 5 && (toX == 7 || toX == 3) &&
(toY == 1 && fromY == 1 || fromY == 8 && toY == 8)) {
	// Castling
	handleCastling(fromX, fromY, toX, toY);
} 
\end{lstlisting}

Ve funkci handleCastling rošádu řeším pomocí uhybání figurek, které rošádě brání.  S funkcionalitou rošády mám v práci mírný problém a to z důvodu malého prostoru pro manipulaci s figury na poslední a první řadě šachovnice. I přesto jsem realizoval kód, který se o její provedení pokouší. Rozděluji si rošádu na dva typy a popíši, jak řeším rošádu za černou barvu.

\popisseznam{
	\polozka {Rošáda doleva} {
		Nejprve se podívám zda před cílovou pozicí věže po rošádě je nějaká figurka. Jestliže ano, přemístím jí dopředu. Poté na místo této figurky posunu krále. Dalším krokem je přemístění věže na její cílovou pozici rošády. Poté diagonálním pohybem umístím krále vedle ní.
	}
	\polozka {Rošáda doprava}{
		Zde je situace odlišná, jelikož jsme schopni využívat 9. horizontální souřadnice šachovnice. Nejprve vyjedu s vězí na tuto souřadnici mimo pole a zde jí posunu o políčko níže. Poté nad ní umístím krále a věž diagonálním pohybem posunu vedle něj. Posledním krokem je posunutí obou figurek o jednu pozici doleva.
	}
}

\podpodkapitola{Braní figury}
V kódu braní šachové figury realizujeme právě ve funkci makeChessMove. Pomocí funkce isPlaceOccupied zjistíme zda jsou cílové souřadnice obsazené či volné. 
\begin{lstlisting}[style=CStyle]
bool isPlaceOccupied(int x, int y) {
	if (!boardValues[y-1][x-1]) {
		return true;
	}
	return false;
}
\end{lstlisting}

V případě, že funkce vrátí true, musíme danou figuru odstranit. To provádíme tak, že ji přesuneme mimo šachovnici neboli na 9. horizontální souřadnici. Do funkce makeMove dáme nejprve současné souřadnice magnetu a poté cílové, kde se náchází figurka. Na braní figurek jsem vytvořil funkci handlePieceTaking. Tato funkce má jako vstupní parametry souřadnice odkud a kam.

\begin{lstlisting}[style=CStyle]
void handlePieceTaking(int fromX, int fromY, int toX, int toY) {
	// Prepare magnet to taken piece
	makeMove(magnetX, magnetY, toX, toY, false);
	
	int movingInRow = toY;
	for (int blockRightX = toX; blockRightX < 9; blockRightX++) {
		// Move taken piece out of chess board
		if (isPlaceOccupied(blockRightX + 1, movingInRow)) {
			if (movingInRow != 0) {
				if (!isPlaceOccupied(blockRightX, movingInRow - 1)) {
					// If piece bellow empty, move there and then continue right
					makeMove(blockRightX, movingInRow,blockRightX+1,movingInRow-1,1);
					movingInRow = movingInRow - 1;
					continue;
				}
			}
			
			if (movingInRow != 8) {
				if (!isPlaceOccupied(blockRightX, movingInRow + 1)) {
				// If piece above empty, move there and then continue right
				makeMove(blockRightX, movingInRow, blockRightX+1, movingInRow+1,1);
				movingInRow = movingInRow + 1;
				continue;
				}
			}
		}
		
		// If empty, move it right
		makeMove(blockRightX, movingInRow, blockRightX + 1, movingInRow, true);
	}
}
\end{lstlisting}

Problematika této funkcionality je, že musíme zajistit volný průchod figury na pravou stranu. Nemůžeme figuru jednoduše přemístit na 9. souřadnici doprava, jelikož by mohla narazit do nějaké jiné šachové figury umístěné na políčkách vpravo.

Programový kód funguje takovým způsobem, že se nejprve podívá o jednu pozici doprava, jestliže je volná, přesune tam figuru pomocí funkce makeMove. V momentě, kdy volná není, podívá se o jednu pozici doprava výše. Jestliže je tato pozice volná, přesune se celý cyklus o Y souřadnici výše a opět se pokouší pohnout doprava. Stejným způsobem funkce kontroluje i pozici pod figurkou. Tímto procesem se figura ve většině běžných šachových situací dostane mimo herní pole. Jsou zde i scénaře, ve kterých by se jí to nepodařilo, ale z důvodu jejich zřídkého vyskytnutí je neřeším.

\podkapitola{Algoritmus vytvořeného programu}
Algoritus pro šachovou hru se odehrává v hlavním cyklu programu. V této části práci si vystvětlíme, jak probíhá od samotného spuštění, po tvorbu tahů oponenta, až po ukončení hry. 

\podpodkapitola{Variablizace hry}
To realizujeme pomocí pátého kontrolního multiplexoru. Tento multiplexor má pouze pět spínačů, a to
\popisseznam{
	\polozka {První dva spínače} {
		Hra za bílé či černé figurky
	}
	\polozka {Další tři}{
		Tyto spínače slouží pro zvolení obtížnosti hry.
	}
}
V kódu variabilazaci sledujeme pomocí podmínek ve funkci setControlMux, která se volá hned na začátku hry. Nejprve přečteme hodnoty spínačů, poté určíme parametry. V momentě, kdy uživatel zvolil barvu a jeden ze spínačů obtížnosti je spuštěný, zahájíme hru přepnutím proměnné gameStarted na true.
\begin{lstlisting}[style=CStyle]
getReedValues(muxEnable[4], 0, 8);
memcpy(controlValues, recordedReedValue, sizeof(controlValues));

//...
if (!controlValues[5]) {
	playingAsWhite = false;
	Q = 8;
	O = 8;
	K = 8;
	R = 8;
	k = 8;
}

if (!controlValues[4]) {
	difficulty = 0;
}
//...

if ((!controlValues[6] || !controlValues[5]) &&
(!controlValues[4] || !controlValues[3] || !controlValues[2])) {
	// Checking if mandatory user info is set
	
	//Serial.println("Game started");
	setupMagnet();
	gameStarted = true;
}
\end{lstlisting}

V případě, že si hráč zvolí začínát hru za černé, je nutné fyzicky prohodit pozice figurek na šachovém poli. Poté začne šachový algoritmus prvním tahem. Ten v kódu provádím jednak nastavním hodnot Q, O, K, R, k na 8 a poté tímto blokem. Ten se provede v případě, že playingAsWhite je nastavný na false a není zaevidován žádný předchozí pohyb algoritmu, neboli je to první tah hry. Pak zavolám Mini-Max funkci getAiMove s prázdnou hodnotou a nový tah provedu.

\begin{lstlisting}[style=CStyle]
if (playingAsWhite == false && lastMoveAI[0] == lastMoveAI[1]) {
	// AI starting as BLACK
	setCurrentBoard();
	memcpy(boardValuesMemory, boardValues, sizeof(boardValuesMemory));
		
	getAIMove("");
	makeChessMove(lastMoveAI);
	resetMove();
}
\end{lstlisting}

\podpodkapitola{Průběh hry} 
V hlavním cyklu programu, po splnění proměnné gameStarted probíhá hra. Kód v cyklu primárně využívá již výše popsané funkce. Zde si ukážeme jejich aplikaci. Samotná záznam části šachové partie je v přílohách pod názvem samoridici\_sachovnice.mov. Nejprve získáme hodnoty spínačů pomocí setCurrentBoard, následně tyto hodnoty uložíme do paměti a spustíme detekci pohybu. V případě, že uživatel hraje za bílé figurky, spustí se funkce detectBoardMovement a běží až do doby, kdy hráč s nějakou figurkou pohne. Tento pohyb se uloží do proměnné move, a ta se předá MiniMax algoritmu pro šachovou hru. Ten rozeberu dále v práci. 

\begin{lstlisting}[style=CStyle]
// Users's turn => waiting for movement
setCurrentBoard();
memcpy(boardValuesMemory, boardValues, sizeof(boardValuesMemory));
while (!move[0] || !move[1] || !move[2] || !move[3]) {
	detectBoardMovement();
}

// AI turn
getAIMove(move);
\end{lstlisting}

MiniMax vyhodnotí zda, byl tah uživatele validní a následně zda je hra u konce či ještě pokračuje. V případě, že tah nebyl validní, což se může stát chybou uživatele a přepnutím jiných spínačů. Vyřešíme to resetem tahu pomocí funkce resetMove.

 Dále nám algoritmus vrátí ideální tah pro oponenta uložený pod externí proměnnou lastMoveAi. Ta obsahuje šachový tah, v šachovém formátu. V práci jsem již implementoval řešení funkční makeChessMove. Tuto funkci zde zavoláme a tah se provede. Po provedení tahu opět vyresetujeme proměnnou move a cyklus spustíme od začátku.
\begin{lstlisting}[style=CStyle]
makeChessMove(lastMoveAI);
\end{lstlisting}

\podpodkapitola{Možnost hry s protihráčem}
Šachovou hru s protihráčem realizujeme pomocí MiniMax algoritmu. Tento šachový algoritmus od pana H.~G.~Mullera \citace{H.G.Mullerův algoritmus}. Program je dostupný pod Open source licencí a pro Arduino ho přepsal pan Diego Cueva. Tento algoritmus jsem objevil v jedné realizaci projektu šachovnice \citace{Projekt automatické šachovnice} a jeho využití jsem si přepsal pro své potřeby.

Kód pro algoritmus je v odlišném souboru, a to v MiniMax.h a MiniMax.cpp. Samotný kód algoritmu je extrémně optimalizován za účelem nejvyšší možné efektivity a délky. Jména proměnných i funkcí jsou zde zkracována, na co nejkratší a kód je díky tomu těžko srozumitelný. V kódu se ideální tah získá pomocí zavolání funkce D.

\begin{lstlisting}[style=CStyle]
 r = D(-I, I, Q, O, 1, 3); /* Think & do*/
\end{lstlisting}

Funkce D obsahuje výpočet Mini-Maxu na základě parametrů pro výhru oponenta. Tento výpočet je velmi koplikovaný a na stránkách pana Mullera uvedených ve zdrojích vysvětlený dopodrobna. Já zde vysvětlím části, které byli důležité pro projení s mým kódem.

Důležitá je zde funkce getAiMove, která má za vstup šachový tah. Algoritmus si tah rozebere a opět provede výpočet. Zde můžeme upravit obtížnost pod proměnnou v kódu určenou jako velké T. Dále je pro nás důležitý status hry. Ten ukládáme do externí proměnné z hlavního souboru gameStatus, kde ji kontrolujeme. V případě výhry ji stanovíme na 2 a v případě prohry na 1.
\begin{lstlisting}[style=CStyle]
  if (!(r > -I + 1)) {
	Serial.println("Lose ");
	gameStatus = 1;
}
\end{lstlisting}

Poslední částí, kterou bych chtěl zmínit je funkce, která zvaliduje a překopíruje daný šachový tah do proměnné lastMove. Zárověn ještě stanoví validMove, což nám určuje zda byl pohyb legální.

\begin{lstlisting}[style=CStyle]
strcpy(lastMove, c); /* Valid human movement */
validMove = true;
\end{lstlisting}

\podkapitola{Mechanické provedení}
Šachovnici bylo zapotřebí umístít do pevného krytu, který bude elektrické součástky chránit před poškozením. Já jsem se rozhodl pro dřevo. Dřevo bylo pro mě volba z důvodu dobrých možností úprav a opracování. Dále se mi také velmi zamlouvalo zachovat dojem klasické šachovnice, která je bězně také dřevěná. Box se skládá ze čtyř zakladních dřevěnných desek. Ze shora a ze spoda je šachovnice uzavřena tenkými překližkami. Samořídící šachovnici jsem v závěru projektu nalakoval ochranou vrstvou. Na šachovnici byly také vypracovány designové prvky a číslování. 

Horní překližka má v sobě zasazenou PCB desku, připevněnou pomocí 8 šroubů, které zárověn společně s cínem drží oba kusy desky pohromady. Do desky jsou vyvedeny kabely od motoru a elektromagnetu. Napajení je realizováno bočním otvorem do šachovnice.

\podpodkapitola{Herní část šachovnice}
 Pro vzhled šachovnice jsem si v programu InkScape vytvořil návrh šachových políček, jenž lze naleznout v přílohách pod názvem navrh\_herniho\_pole.pdf. Na pravou část návrhu jsem umístil kontrolní spínače pro volbu hry. Návrh jsem si nechal vytisknout na pevný papír, jenž jsem na desku přilepil. Pro šachovnici jsem si nechal vytisknout vhodné šachové figurky pomocí 3D tisku a do nich vložil malé magnety.\obrazek{chessVzhled}{Vzhled herní části šachovnice}{16cm}{sachyVzhled.jpg}

\kapitola{Závěr}
Samořídící šachovnice byla v rámci práce zrealizována. Je schopna detekovat figurky umístěné na jejím herním poli. Rešení byla deska plošného spoje s potřebnými součástkami. Deska obsahuje 69 magnetických spínačů, které skrze multiplexory čteme pomocí řídící jednotky. Jako řídící jednotku jsem si zvolil Arduino UNO, které dostatečně plní všechny potřebné úlohy práce. Šachovnice s mírnými odchylky umožnuje šachovou hru proti oponentovi, kterého simuluje algoritmus. 

Pro účely řízení jsem vytvořil program, který je schopen ovládat všechny potřebné části šachovnice. Program je schopen řešit situace, které během hry mohou nastat. Dokáže zařídit odpověd na šachový tah hráče, který rozpozná na základě sepnutí spínačů. Pro tento účel využívá algoritmus Mini-Max, který pomocí výpočtů zjistí ideální odpovídající tah. Následně tento tah transformuje do signálů, které jsou schopné vykonat krokové motory a přemístí požadovanou šachovou figurku na odpovědné místo. 

Samořídící šachovnici jsem zkonstruoval do dřevěné skříně, ve které jsou umístěny všechny potřebné prvky. Je do ní z boční strany přivedeno odpovídající napětí. Toto napětí nám stabilizátor umožní variovat pro motory, eletromagnet a ostatní součástky.

Dovnitř šachovnice jsem sestrojil sestavu krokových motorů, která je schopna provádět pohyb po XY souřadnicích. Tento mechanismus je sestrojen pomocí umístění vnitřní plošiny na vodicí tyče v konstrukci. Touto plošinou je proveden řemen zakončený řemenicí. Na horizontální ose je podobný mechanismus. Je na ní však použit elektromagnet, který pohybuje s figurkami.

Pro projekt jsem zařídíl šachové figurky vytvořené pomocí 3D tisku, do kterých jsem umístil malé magnety. Návrh pro herní pole jsem vytvořil a následně ho nechal vytisknout na vhodný materiál. Ten je připevněný na desku plošného spoje.

\seznamObrazku

\prilohy{
	\kapitola{Samořídící šachovnice}
	\podkapitola{schema\_sachovnice.pdf}
	\podkapitola{navrh\_herniho\_pole.pdf}
	\podkapitola{samoridici\_sachovnice.mov}
}

\literatura{

	\url{Arduino}{conrad.cz}{Arduino® » Praktický mikrokontrolér pro individuální spínací a řídicí úlohy}{https://www.conrad.cz}{2024}{29. 2. 2024}{https://www.conrad.cz/cs/clanky/elektromechanika/arduino.html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}
	\url{PCB deska}{botland.cz}{Deska PCB – co to je?}{https://botland.cz/}{2023}{13. 3. 2023}{https://botland.cz/blog/deska-pcb-co-to-je/}
	\url{Magnetický spínač}{uk.rs-online.com}{reed-switches-guide}{https://uk.rs-online.com}{2023}{1. 2. 2023}{https://uk.rs-online.com/web/content/discovery/ideas-and-advice/reed-switches-guide}
	\url{Multiplexor}{dubno.cz}{VY\_32\_INOVACE\_CTE\_2.MA\_13\_Multiplexory}{https://dubno.cz/}{2012}{1.8.2012}{https://dubno.cz/images/stories/dum/8.sablona/24/pdf/\\VY\_32,\_INOVACE\_CTE\_2.MA\_13\_Multiplexory.pdf}
	\url{Stabilizátor}{wikipedia.cz}{Stabilizátory napětí}{https://www.wikipedia.cz}{2024}{22.2.2024}{https://cs.wikipedia.org/wiki/Stabiliz\%C3\%A1tor\_nap\%C4\%9Bt\%C3\%AD}
	\url{Krokový motor}{lastminuteengineers.com}{28byj48-stepper-motor-arduino-tutorial/}{https://lastminuteengineers.com}{2025}{23. 3. 2025}{https://lastminuteengineers.com/28byj48-stepper-motor-arduino-tutorial/}
	\url{Elektromagnet}{cs.wikipedia.org}{Elektromagnet}{https://cs.wikipedia.org/}{2025}{25. 1. 2025}{https://cs.wikipedia.org/wiki/Elektromagnet}
	\url{Mini-Max}{geeksforgeeks.com}{mini-max-algorithm-in-artificial-intelligence}{https://www.geeksforgeeks.org/}{2024}{27.8.2024}{https://www.geeksforgeeks.org/mini-max-algorithm-in-artificial-intelligence/}

	\url{Projekt automatické šachovnice}{https://www.instructables.com}{Automated-Chessboard}{https://www.instructables.com}{2022}{2.1.2022}{https://www.instructables.com/Automated-Chessboard/}
	\url{Projekt řízené šachovnice}{https://projecthub.arduino.cc}{maguerero/automated-chess-board-67db6f}{https://projecthub.arduino.cc}{2018}{24.10.2018}{https://projecthub.arduino.cc/maguerero/automated-chess-board-67db6f/}
	\url{H.G.Mullerův algoritmus}{home.hccnet.nl}{/h.g.muller/max-src2}{https://home.hccnet.nl/}{2025}{25.3.2025}{https://home.hccnet.nl/h.g.muller/max-src2.html}
		
	\url{PCB SMT a THT}{pcba-manufacturers.com}{SMT vs THT}{2023}{23. 3. 2023}{https://www.pcba-manufacturers.com/smt-vs-tht/}
	\url{Arduino UNO}{store.arduino.cc}{Arduino UNO pinout}{2025}{19. 3. 2025}{https://store.arduino.cc/en-cz/products/arduino-uno-rev3}
	\url{Mini-Max grafika algoritmus}{https://www.tpointtech.com}{minimax-algorithm-in-python}{https://www.tpointtech.com/}{2025}{23.3.2025}{https://www.tpointtech.com/minimax-algorithm-in-python}

}

\konec
