realWalter05/automated_chess/docs/latex/document.pdf

Střední průmyslová škola a Vyšší odborná škola, Písek, Karla Čapka 402, Písek

18-20-M/01 Informační technologie

# Maturitní práce

# Elektromechanická hra ->

# samořídící šachovnice

Téma číslo 4.

autor:

Václav Zíka, B4.I

vedoucí maturitní práce:

Mgr. Milan Janoušek

Písek 2024/2025

## Licenční smlouva o podmínkách užití školního díla

ve smyslu zákona č. 121/2000 Sb. o právu autorském, o právech souvisejících s právem

autorským a o změně některých zákonů (autorský zákon) v platném znění (dále jen „AZ“),

uzavřená mezi smluvními stranami:

1. Autor práce: Václav Zíka
bytem Na Spravedlnosti 974/36, Písek 39701, Česká republika

datum narození: 29. 12. 2005

(dále jen „autor“)

a

2. Nabyvatel: Střední průmyslová škola a Vyšší odborná škola, Písek, Karla

Čapka 402, Písek

397 11 Písek, Karla Čapka 402

(dále jen "nabyvatel")

zastoupená ředitelem školy: Ing. Jiří Uhlík

Článek 1

Vymezení pojmů

1.1 Školním dílem dle §60 AZ se pro účely této smlouvy rozumí dílo vytvořené žá-

kem/studentem ke splnění školních nebo studijních povinností vyplývajících z jeho

právního postavení ke škole.

1.2 Licencí se pro účely této smlouvy rozumí oprávnění k výkonu práva školní dílo užít

v rozsahu a za podmínek dále stanovených.

Článek 2

Dílo

2.1 Předmětem této smlouvy je poskytnutí licence k užití školního díla – maturitní

práce.

Název práce (dále jen „dílo“): Elektromechanická hra -> samořídící šachovnice

vedoucí práce: Mgr. Milan Janoušek

odevzdané nabyvateli v elektronické formě dne 31. 3. 2025.

2.2 Autor prohlašuje, že:

– vytvořil dílo, specifikované touto smlouvou, samostatnou vlastní tvůrčí čin-

ností;

– při zpracovávání díla se sám nedostal do rozporu s autorským zákonem a před-

pisy souvisejícími;

– dílo je dílem původním;

– neposkytl třetí osobě výhradní oprávnění k užití díla v rozsahu licence poskyt-

nuté nabyvateli dle této smlouvy před podpisem této smlouvy;

– je si vědom, že před zamýšleným poskytnutím výhradního oprávnění k užití

díla v rozsahu licence poskytnuté nabyvateli dle této smlouvy třetí osobě, je

povinen informovat tuto třetí osobu o skutečnosti, že již poskytl nevýhradní

licenci k užití díla nabyvateli.

2.3 Dílo je chráněno jako dílo dle autorského zákona a dle zákona č. 89/2012 Sb., ob-

čanský zákoník (dále jen „Občanský zákoník“).

Článek 3

Poskytnutí licence

3.1 Licenční smlouvou autor poskytuje nabyvateli oprávnění k výkonu práva dílo užít

pro účely výuky na Střední průmyslové škole a Vyšší odborné škole, Písek, Karla Čapka 402, a pro vnitřní potřebu školy, ze které neplyne škole hospodářský výsledek.

3.2 Licence je poskytována pro celou dobu trvání autorských a majetkových práv k dílu.

3.3 Autor poskytuje nabyvateli oprávnění užít dílo způsoby podle 3.1 neomezeně.

3.4 Autor poskytuje nabyvateli oprávnění užít dílo bezúplatně za splnění podmínky,

že nabyvatel nebude užívat dílo za účelem dosažení zisku a nebude-li v budoucnu

dohodnuto písemně jinak.

Článek 4

Údaje o autorství

4.1 Nabyvatel se zavazuje, že uvede údaje o autorství autora dle Autorského zákona.

Článek 5

Poskytnutí licence

5.1 Pokud to není v rozporu s oprávněnými zájmy nabyvatele, licence je poskytována

jako nevýhradní. Nabyvatel je oprávněn postoupit tuto licenci třetí osobě a udělovat

podlicence za splnění podmínek uvedených v § 48 Autorského zákona.

5.2 Autor může své dílo užít či poskytnout jinému licenci, není-li to v rozporu s opráv-

něnými zájmy nabyvatele, za podmínky, že nabyvatel (dle této licenční smlouvy)

je oprávněn po autoru školního díla požadovat, aby přiměřeně přispěl na úhradu

nákladů, tak, jak je stanoveno v § 60 odst. 3 zákona Autorského zákona.

5.3 Nabyvatel není povinen dílo užít.

5.4 Nabyvatel je oprávněn dílo spojovat s jinými díly i zařadit dílo do díla souborného.

Autor dává svolení k tomu, aby nabyvatel pořídil pro účely užití uvedené v této

smlouvě překlad díla.

5.5 V případě, že z díla plyne hospodářský výsledek autorovi nebo nabyvateli, rozdělení

zisku bude řešeno dodatkem k této smlouvě.

Článek 6

Výpověď smlouvy

6.1 Každá smluvní strana může smlouvu kdykoliv písemně vypovědět bez udání úvodu.

6.2 Výpověď musí být učiněna doporučeným dopisem doručeným druhé smluvní straně.

Výpovědní lhůta je stanovena na dva měsíce a začíná běžet prvním dnem kalendář-

ního měsíce následujícího po měsíci, v němž byla výpověď doručena druhé smluvní

straně.

6.3 Autor nahradí Nabyvateli škodu, která mu odstoupením od smlouvy podle odstavce

1 a 2 vznikla. Účinky odstoupení nastanou nahrazením škody nebo poskytnutím

dostatečné jistoty.

Článek 7

Závěrečná ustanovení

7.1 Smlouva je sepsána ve dvou vyhotoveních s platností originálu, která budou vložena

do dvou výtisků díla (práce), z toho nabyvatel i autor obdrží po jednom vyhotovení.

7.2 Vztahy mezi smluvními stranami vzniklé a neupravené touto smlouvou se řídí au-

torským zákonem a občanským zákoníkem v platném znění, popř. dalšími právními

předpisy.

7.3 Smlouva byla uzavřena podle svobodné a pravé vůle smluvních stran, s plným po-

rozuměním jejímu textu i důsledkům, nikoli v tísni a za nápadně nevýhodných

podmínek.

7.4 Smlouva nabývá platnosti a účinnosti dnem jejího podpisu oběma smluvními stra-

nami.

V Písku dne 31. 3. 2025

Autor:

Nabyvatel:

## Anotace

Maturitní práce se zabývala tvorbou samořídící šachovnice, jejíž cílem bylo kompletně

simulovat protihráče. Ať už se jedná o vymýšlení protitahu či o samotný manuální posun figurky. Šachovnice je ovládána mikrokontrolérem Arduino UNO. Pomocí magnetických

spínačů umístěných na PCB detekujeme pozici figurek na hracím poli. Tyto informace

následně zpracováváme Arduinem a skrze dva krokové motory a elektromagnet realizujeme

tahy figurek. Pro zjištění ideálního příštího tahu využíváme MiniMax algoritmus, jenž je

schopný zevaluovat danou situaci a skrze programovou logiku udat příkazy pro pohyb

figurek. Celá samořídící šachovnice je vyrobena z dřevěné konstrukce, do které je umístěna deska plošného spoje s elektronikou. Šachové figurky použité v projektu jsou vytvořené

pomocí 3D tisku.

Klíčová slova: Samořídící šachovnice, automatizace, programové řízení

## Annotation

Graduation thesis focuses on construction of self-controlling chessbord. The goal of

the work is to completely simulate opponent. within the simulation, we should be able

to come up with ideal counter move and manual movement of the piece. The chessboard

is controlled by a microcontroller Arduino UNO. We use reed switches situated on a

PCB to detect position of chess pieces. These information we proccess with Arduino and

through two stepper motors and an electromagnet we realize moves. To detect ideal next

move we use MiniMax algorithm, which is able to evaluate given situation and through

program logic set signals for stepper motors. The self-controlling chessboard is made out

of wooden construction inside which is installed printed circuit board with neccessary

electronics. Chess pieces used in project have been made by 3D print.

Key words: Self-controlling chessboard, automatization, program control

Poděkování

Chtěl bych poděkovat panu Mgr. Janouškovi za podporu a vedení práce. Za jeho odborné

rady a konzultace ohledně možných řešení. Také bych chtěl vyjádřit dík panu Táborovi,

Kutilovi, Kolpovi a panu Vondrákovi.

# Obsah

1 Úvod | 9
2 Teoretická část | 10
3 Praktická část | 14

4 Závěr | 36
Přílohy | 37
A schema_sachovnice.pdf | 38

# Kapitola 1

# Úvod

Nápad pro automatickou šachovnici jsem dostal při hledání nového projektu, který

bych si doma zvládl sestrojit. Chtěl jsem, aby projekt obsahoval, jak část softwarovou,

kterou jsem se do té doby primárně zabýval, tak i část mechanickou, kterou by bylo nutné

vyrobit.

Napadlo mě vytvořit nějakou deskovou hru pro více hračů. V té době jsem měl ve

velké oblibě šachy, a proto vznikla idea automatické šachovnice. Začal jsem nákresem na papír a tím jsem získal základní představu o projektu. Šachovnice by se skládala ze tří

hlavních částí:

Konstrukční část Konstrukční část se skládá ze samotné dřevěné konstrukce šachov-

nice, do které bude nutné umístít mechanismus pro pohybování s figurkami. V rámci

toho také její opracování a nadesignování projektu. Tvorba šachových políček a roz-

hraní pro jednoduché ovládání.

Elektrotechnická část Ta obsahuje systém pro detekci figurek na šachovnici. Ten by

se dal vytvořit pomocí mnoha způsobů, ale v práci budu popisovat řešení pomocí

desky plošného spoje. Dále vytvoření pohybové soustavy pomocí krokových motorů

a umístění elektromagnetu, který bude s figurkami pohybovat. Posledním krokem je

sestrojení systému, který dovolí hráči nastavit jakou obtížnost bude mít oponent.

Softwarová část Z hlediska softwaru je nutné vytvořit kód, který spojí všechny části

dohromady. Je nutné transformovat signály tak, aby s nimi bylo možné pracovat.

Z hlediska kódu je nutné vytvořit rozhraní pro komunikaci mezi mikrokontrolérem

a součástkami. Je zapotřebí umožnit evaluaci dat o pozicích figurek a předat je

algoritmu, který nám bude schopen vymyslet další tah.

# Kapitola 2

# Teoretická část

V této kapitole si popíšeme technologie, které byly zapotřebí při tvorbě projektu.

Získáme k nim teoretický základ nutný k porozumění šachovnice.

## 2.1 Arduino

Arduino je platforma pro tvorbu různých elektronických projektů. Zabývá se hard-

warem a softwarem a obě tyto části vytváří jako open-source. To je jeden z důvodů

velkého rozšíření mikrokontrolerů Arduino.

Mikrokontrolér Arduino je malý počítač založen na jednom čipu. Arduino vyrábí

mnoho různých řad jejich projektů, ale mezi nejznámější se řadí Arduino UNO či Mega.

Arduino desky na sobě mají široké spektrum možných vstupů, výstupů a senzorů. Velkou

výhodou těchto desek je cena. Ta se pohybuje v řádech stovek korun.

Arduino desky se primárně programují pomocí platformy Arduino IDE. To je další

open-source program, který má na základě popularity mezi lidmi i velkou podporu kniho-

ven s různými zaměřeními.

## 2.2 Deska plošného spoje

PCB deska, jak je zkratkou nazývána, nebo také DPS je velmi rozšířená elektronická

součástka. Desky jsou vyrobené z izolačních materiálů s pájecími poli, kterým se říká pod-

ložky a elektrickými spoji nazývanými stopy. Na PCB desky se připájí potřebné součástky.

Tyto součástky jsou spolu pak propojeny na základě schématu pro tvorbu PCB. Jsou dvě

primární technologie montáže součástek na desku. Je tady technologie průchozích otvorů

(THT, Through-Hole Technology), nebo povrchové montáže (SMD, Surface-Mounted De-

vices) viz. obr. 2.1. Při povrchové montáži se napájí součástky přímo na desku s tím, že

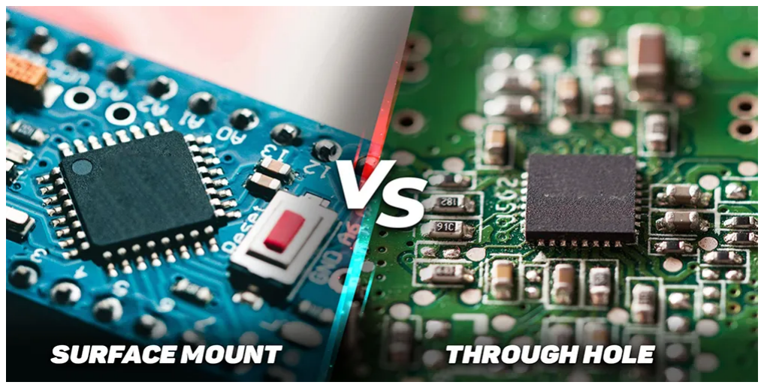
[picture p3: figure]

Obrázek 2.1: Rozlišení SMT a THT na PCB desce

jsou na ní připravené jednotlivé stopy. U THT jsou v desce připravené otvory, do kterých

součástky umísťujeme.

## 2.3 Elektronické součástky

### 2.3.1 Magnetický spínač

Tento typ spínače je elektronický obvod aktivovaný pomocí magntického pole. Nej-

běžnější je konstrukce pomocí dvou feromagnetických kovů umístěných kousek od sebe

ve skleněné kapsli. V momentě, kdy je ke spínači přiložen magnet se kovy spojí a začnou

vodit. Magnetické spínače jsou například využívány pro detekci uzavření dveří.

### 2.3.2 Multiplexor

Tato elektronická součástka slouží k přepínání vstupů na jeden výstup na základě řídí-

cích signálů. Multiplexor je realizován integrovanými obvody. Pomocí této součástky jsme

napřílad schopni zvětšit počet vstupů na určitém zařízení o počet vstupů na multiplexoru,

s tím že do zařízení zapojíme pouze multiplexor. Tento postup je ideální v momentě, kdy

máme zařízení s nedostatkem vstupů pro dané využití.

### 2.3.3 Stabilizátor

Stabilizátor nám zajištuje výstupní nápětí bez ohledu na změny výstupního proudu

či vstupního napětí. Stabilázátory se dělí na lineární paremetrický, lineární zpětnovazební a spínací zpětnovazební. Stabilizátory fungují na principu regulace odporu pomocí

tranzistoru na základě referečního napětí a napětí žádaného. Ke stabilizátoru se přidá-

vají kondenzátory, které eliminují šum a stabilizují výstup. Lineární stabilizátory regulují

napětí, tím že fungují jako proměnný odpor mezi vstupem a výstupem.

### 2.3.4 Elektromagnet

Elektromagnetem se rozumí cívka pomocí, které jsme schopni vytvořit dočasné mag-

netické pole. Jádro této cívky je z magneticky měkké oceli. V momentě, kdy začneme

cívkou vést proud, začne se okolo ní vytvářet magnetické pole. Velikost a polaritu tohoto

pole jsme schopni ovládat.

### 2.3.5 Krokový motor

Krokový motor je zařízení, které nám dovolí na základě elektromagnetických pulsů

přesně rotovat. V motoru je ozubené kolo, které můžeme otáčet na základě polových

dvojic. Pomocí pulsování jednotlivá pole přitáhnou ozubené kolo a na základě tohoto jevu,

můžeme motor otočit o přesný počet kroků. Rychlost rotování jsme schopni korigovat na

základě změn frekvence aktivace polí. To realizujeme skrze ovladače krokových motorů.

## 2.4 Mini-Max algoritmus

Tento typ algorithmu je fundamentálním konceptem umělé inteligence a teorie her.

Mini-Max má za cíl zminimalizovat možnou ztrátu na základě analýzy nejhorších možných

scénářů, neboli min, a těch nejlepších, max. Ve hře pro dva hráče si algoritmus vytvoří dvě

interní entity. Ta první se jmenuje Maximizer a cílí získat nejvyšší možné skóre. Oproti ní

druhá, Minimizer, má za cíl, co nejvíce skóre Maximizer snížit. Toho docílí tak, že evaluuje

všechny možné tahy obou hráčů zároveň.

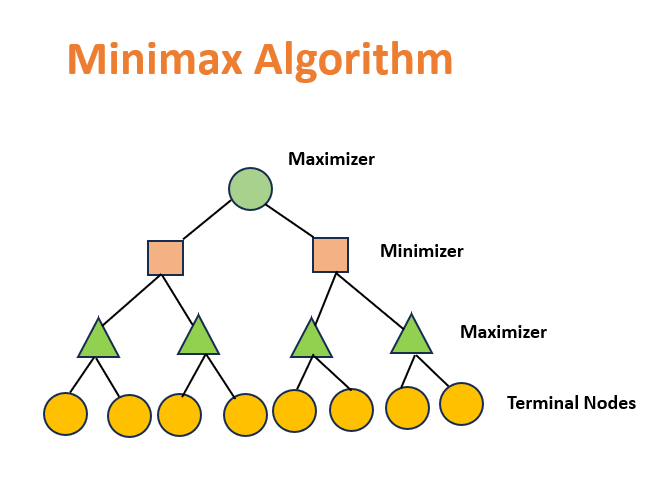
[picture p4: figure]

Obrázek 2.2: Minimax algoritmus

Z počátku si Mini-Max vytvoří tzv. herní strom. Účelem tohoto stromu je reprezentovat

všechny možné tahy, které mohou v daný moment ve hře nastat. Dalším krokem je, že

u tzv. závěrečných stavů (terminal nodes) určí skóre. Skoŕe se určuje na základě kritérií

daných v kódu a postupně ve stromu postupuje výše a určuje skóre dál. Poté, co Mini-

Max určí skóre pro všechny možné stavy, projde jednotlivé scénáře. V kole Maximizera

volí variantu s nejvyšším možným skórem. Naopak v kole minimizera tu s nejnižším. Podle

nejvyššího možného celkového skóre algoritmus určí příští zvolený blok.

# Kapitola 3

# Praktická část

## 3.1 Elektrické zapojení

Pro projekt bylo zapotřebí vymyslet efektivní a spolehlivý způsob propojení. Zároveň

však způsob nesměl bránit detekci figurek pomocí spínačů. Nabízela se spoustu možností,

ale z důvodů velkého množství součástek jsem se rozhodl pro dle mě nejčistčí řešení, a to

desku plošného spoje.

### 3.1.1 PCB deska

Deska plošného spoje bylo řešením, které se nabízelo kvůli spolehlivosti a zároveň tím,

že deska je velmi tenká a její materiál nijak nebrání průchodu magnetického pole. Na

základě mého schématu v programu EasyADA jsem si desku nechal sestrojit. Schéma

šachovnice najdete v přílohách pod názvem schema_sachovnice.pdf. Z důvodu výrobních

možností a rozměrů desky byla deska sestrojena na dvě poloviny. Tyto poloviny jsem

spájel dohromady. Deska byla vyrobena technologií SMT, takže jsem na ní povrchově

připájel piny pro všechny potřebné součástky. A to

- 69 jazýčkových magnetických kontaktů
- 5 analogových multiplexorů, transistor a různé drobné zařízení
- Mikrokontroler Arduino UNO
- Dva A4988 ovladače pro krokové motory
- Stabilizátor a piny pro vstupní napětí
- Napájení pro motory a elektromagnety


Obrázek 3.1: porovnání PCB desky z výroby a osázené

Desku jsem si následně nechal pocínovat. Dvě části jsem pomocí propojek spojil do-

hromady. Během práce jsem posléze při detekci figurek musel řešit velký problém, a to se

spolehlivostí desky. Magnetické spínače nefungovaly spolehlivě. Důvodem byly narušené

cesty a také křekhost spínačů. Ty během pájení velmi snadno praskly.

Tyto problémy jsem řešil za pomocí multimetru a posléze detekcí pomocí počítače.

Na desce jsem postupně zkontroloval všechny cesty a v momentě, kdy špatně vodily jsem

na ně napájel vrstvu cínu. Pokud problém spočíval v propojení dvou vedlejších cest, vzal

jsem nůž a cín manuálně odstranil. Největším úśkalím bylo manuální propojení dvou desek

dohromady. Tato část desky vyžadovala časově velmi úpornou manuální péči.

Desky se mi po opravách podařilo dostat do spolehlivého stavu. Jednou věcí, která

mi však projekt stížila bylo, že nespolehlivost cest na desce a spínačů jsem objevil až v momentě, kdy jsem programoval detekci figurek. V tuto chvíli jsem však již, alespoň mohl

využít napojení na multiplexory a pomocí kódu je kontrolovat skrze konzoly na počítači.

To usnadilo proces oprav.

Deska je napájena externím 18V zdrojem. Na desce se pomocí stabilizátoru pro většinu

součástek nastaví napětí 5V, avšak pro motory a elektromagnet zůstává napětí 18V.

### 3.1.2 Výběr řídící jednotky

Mikrokontrolér, který jsem si vybral pro samořídící šachovnici je Arduino UNO. Toto

Arduino splňovalo veškeré nutné požadavky pro ovládání a zároveň to byl mikrokontroler,

který jsem měl z počátku projektu doma a mohl jsem na něm zprvu testovat. Arduino je

napájeno 5V z PCB desky a ovládá celou šachovnici. Arduino je naprogramováno varian-

tou jazyku C++, ale o tom budu psát podrobněji později v práci. Do mikrokontroleru jsou

skrze multiplexory zapojeny všechny magnetické spínače. Arduino si pomocí programové

logiky přepíná jaký z multiplexorů bude v dané chvíli aktivní, jelikož data multiplexorů

proudí po stejných cestách. Dále jsou do Arduina zapojené drivery motorů a transistor,

který slouží k ovládání elektromagnetu.

## 3.2 Detekce obsazenosti políček

V této kapitole popíši, na jakém principu se v šachovnici detekují pozice figurek. Vy-

světlím jednotlivé zapojení multiplexorů a kód, který je ovládá. Spolehlivé detekování

pozice figurek je stěžejním bodem této práce, jelikož z něho vychází další operace pro-

jektu.

### 3.2.1 Zapojení a princip

Aby samořídící šachovnice fungovala je zapotřebí vědět pozici figurek na herním poli.

Nabízí se dvě řešení. Detekce pomocí kamer a zpracování obrazu a pomocí magnetických spínačů. Řešení pomocí kamer jsem zavrhl, jelikož by to znamenalo nějaké rameno na

šachovnici s kamerou. To mi nepřipadalo ideální. Magnetické spínače nám zachovají čistý

vzhled šachovnice. Jelikož však na šachovnici máme 64 políček, potřebujeme 64 spínačů.

Tolika piny naše Arduino Uno nedisponuje, a tak je zapotřebí využít nějaký systém po-

mocí, kterého počet vstupů snížíme.

Po průzkumu a práci na řešení jsem se inspiroval z jednoho projektu dostupného na

internetu [9]. V tomto projektu bylo využito multiplexorové řešení. Zapojíme piny spínačů

do multiplexoru, a ten pak čteme pomocí řídící jednotky. Pomocí tohoto postupu jsme

schopni zredukovat 64 pinů na 4 multiplexory. V této práci jsem jich využil pět, jelikož

poslední multiplexor se stará o volbu obtížností a barvy.

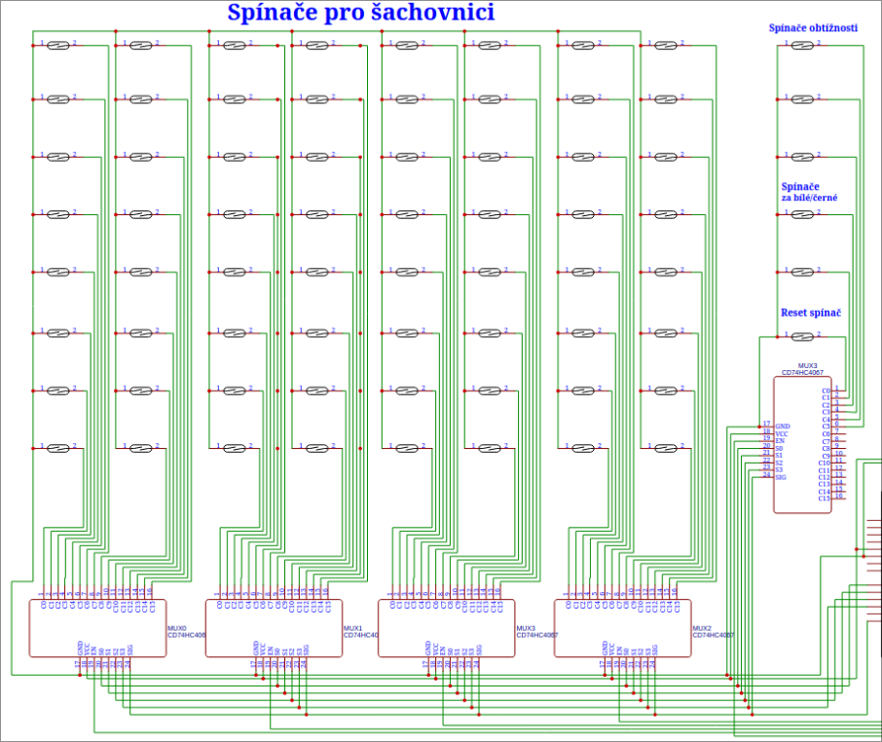
[picture p5: figure]

Obrázek 3.2: Zapojení magnetických spínačů na desce

Multiplexory, které jsem využil mají 16 datových vstupů, 4 vstupy adresové, nápajení,

zem, zapínací pin EN a výstup SIG. Výstupy multiplexorů, jak je vidět na schématu viz.

obr. 3.2, jsou zapojeny do stejných cest na PCB desce. Stejně tak výstup SIG je pro

všechny multiplexory stejný. Toto není problém, jelikož v kódu využivám pin Enable

(en). Jestliže je tento pin v logické jedničce, je multiplexor vypnutý. V momentě, kdy je

v logické nule, je zapnutý. Na základě tohoto principu jsme schopni přepínat přepínače

samotné a tím ještě více zminimalizovat počet nutných vstupů do Arduina UNO.

### 3.2.2 Programový kód

Jak už jsme zmínili, šachovnice je ovládána mikrokontrolerem Arduino UNO, jenž

se programuje variantou C++. Kód pro ovládání multiplexorů nám musí zajistit jejich přepínání pomocí Enable pin a stabilní detekci pozic. První věc, kterou musíme v kódu

nastavit jsou Enable piny. Po zapnutí nastavím Enable pin jako OUTPUT a pomocí for

loopu si procyklujeme všechny Enable piny multiplexorů a dáme na ně logickou jedničku.

Tato část kódu je v setup() funkci kódu. Ta se spustí pouze po spuštění mikrokontroleru.

1 | // Di s a bli n g M ul ti pl e x e r s | (When high − doe s no thing )
2 | f o r ( i n t i = 0 ; i < 5 ; i++) {
3 | pinMode ( muxEnable [ i ] , OUTPUT) ;
4 | d i g i t a lW r i t e ( muxEnable [ i ] , HIGH) ;
5 | }

6
7 | f o r ( i n t i = 0 ; i < 4 ; i++) {
8 | pinMode (muxAddr [ i ] , OUTPUT) ;
9 | d i g i t a lW r i t e (muxAddr [ i ] , LOW) ;
10 | }

Čtení hodnot pomocí getReedValues()

Pro čtení hodnot využíváme funkci getReedValues. V ní nejprve zaktivujeme mul-

tiplexor tím, že mu nastavíme pin na 0. Poté začneme na jeho adresové piny vysílat

binarní kombinace od 0 do 15. Toho docíleme opět pomocí for cyklu a využití modulo

funkce (v kódu jako %). Data následně ukládáme do našeho interního variablu muxValues

a poté, co deaktivujeme multiplexor a jeho adresové vstupy, překopírujeme pomocí funkce

memcpy hodnoty do proměnné recordedReedValue, která nám slouží pouze pro ukládání

nejnovější možné detekce pozic.

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

5
6 | // A c ti v a ti n g MUX
7 | d i g i t a lW r i t e ( targetMuxAddress , LOW) ;

8
9 | f o r ( i n t j = from ; j < to ; j++) {
10 | // Checking MUX combina tion s
11 | d i g i t a lW r i t e (muxAddr [ 0 ] , j % 2 ) ;

12 | d i g i t a lW r i t e (muxAddr [ 1 ] , j / 2 % 2 ) ;
13 | d i g i t a lW r i t e (muxAddr [ 2 ] , j / 4 % 2 ) ;
14 | d i g i t a lW r i t e (muxAddr [ 3 ] , j / 8 % 2 ) ;

15
16 | i n t reedValue = di gi t al R e a d (muxOutput ) ;

17
18 | i f ( j > 7 ) {
19 | muxValues[7−( j −8) ] = reedValue ;
20 | } e l s e {
21 | muxValues [ j ] = reedValue ;
22 | }
23 | }

24
25 | // R e s e t ti n g MUX
26 | d i g i t a lW r i t e (muxAddr [ 0 ] , LOW) ;
27 | d i g i t a lW r i t e (muxAddr [ 1 ] , LOW) ;
28 | d i g i t a lW r i t e (muxAddr [ 2 ] , LOW) ;
29 | d i g i t a lW r i t e (muxAddr [ 3 ] , LOW) ;

30
31 | d i g i t a lW r i t e ( targetMuxAddress , HIGH) ;
32 | memcpy ( recordedReedValue , muxValues , s i z e o f ( reco rdedReedValue ) ) ;
33 | }

Jelikož je SIG pin multiplexorů nastavený jako INPUT_PULLUP, což je nutné pro

detekci zda spínač spíná zem či je rozpojený, dostávám všechny rozpojené spínače jako

jedničky. Ty seplé jako nuly. Ve výsledku může výstup v konzoli po zahájení hry vypadat

takto.

8 - 0 0 0 0 0 0 0 0

7 - 0 0 0 0 0 0 0 0

6 - 1 1 1 1 1 1 1 1

5 - 1 1 1 1 1 1 1 1

4 - 1 1 1 1 1 1 1 1

3 - 1 1 1 1 1 1 1 1

2 - 0 0 0 0 0 0 0 0

1 - 0 0 0 0 0 0 0 0

–––-A B C D E F G H

Ukládání všech pozic

Předchozí funkce nám zajištuje přečtení hodnot multiplexoru na základě daných pa-

rametrů. V kódu máme další pomocnou funkci setCurrentBoard(). Cílem této funkce je

projít všechny řady šachovnice od první až po osmou a uložit je do mikrokontroleru. V

mikrokontroleru je opět pomocí funkce memcpy překopíruje do dvouřadého listu boar-

dValues, který obsahuje všechny pozice figurek.

1 | void se tCu r ren tBoa rd ( ) {
2 | ge tReedValues ( muxEnable [ 0 ] , 0 , 8 ) ;
3 | memcpy ( boa rdValues [ 0 ] , recordedReedValue , s i z e o f ( boa rdValues [ 0 ] ) ) ;

4
5 | ge tReedValues ( muxEnable [ 0 ] , 8 , 16 ) ;
6 | memcpy ( boa rdValues [ 1 ] , recordedReedValue , s i z e o f ( boa rdValues [ 1 ] ) ) ;
7 | // | ano the r f i v e r ea d s
8 | ge tReedValues ( muxEnable [ 3 ] , 8 , 16 ) ;
9 | memcpy ( boa rdValues [ 7 ] , recordedReedValue , s i z e o f ( boa rdValues [ 7 ] ) ) ;

Detekce přemístění figurek

Předchozí funkce v této kapitole nám vysvětlují, jak šachovnice data čte. Nadcházející

funkce je však zodpovědná za samotnou detekci změny pozic, při kterých uživatel vezme

figurku do ruky a přendá ji na jiné políčko. Tato funkce je napsána bloku loop(). To je

opět platformou Arduino daná funkce, která se po spuštění již zmíněné funkce setup()

neustále opakuje.

Abychom zjistili, zda se událo přemístění figurky musíme pravidelně číst pozice hodnot

a porovnávat je z přechozími. To děláme pomocí while cyklu, který se opakuje do doby,

než jsou splněné podmínky uvedené v závorkách. Podmínky, které jsou v kódu nastavené

vyžadují, aby list proměnných move obsahoval čtyři hodnoty. Neboli hodnotu čísla a pís-

mena odkud se figurka přemístila a hodnoty kam. Jak zjistíme hodnoty, které ukládáme

do move, vysvětlím dále v textu. Nejprve tedy uložíme hodnoty pozic do proměnné bo-

ardValuesMemory a následně přejdeme do cyklu. V tomto cyklu se neustále volá funkce

detectBoardMovement() až do splnění zmíněných podmínek.

1 | // Pla y e r ’ s tu rn => wai ti ng f o r movement
2 | memcpy ( boardValuesMemory , boardValues , s i z e o f ( boardValuesMemory ) ) ;
3 | w hil e ( ! move [ 0 ] | | ! move [ 1 ] | | ! move [ 2 ] | | ! move [ 3 ] ) {
4 | detectBoardMovement ( ) ;
5 | }

Funkce detectBoardMovement()

Pomocí této funkce detekujeme, zda bylo uskutečněno přemístění figurek. Tato funkce

je volána cyklicky z while loopu dokud nenajdeme čtyři hodnoty pro proměnnou move.

Např. e2e4 by nám značilo pohyb z počátku hry pěšče o dvě místa z e2 na políčko e4.

Funkce porovnává současné hodnoty pozic v proměnné boardValues, které nastaví pomocí

funkce setCurrentBoard() s hodnoty boardValuesMemory uloženými v hlavním cyklu před

zahájením while cyklu.

1 | void detectBoardMovement ( ) {
2 | se tCu r ren tBoa rd ( ) ;

3
4 | f o r ( i n t i = 7 ; i >= 0 ; i −−) {
5 | f o r ( i n t j = 7 ; j >= 0 ; j −−) {
6 | i f ( boardValuesMemory [ i ] [ j ] != boardValues [ i ] [ j ] ) {
7 | // P o si ti o n o f p i e c e has change s
8 | i f ( boa rdValues [ i ] [ j ] ) {
9 | // Pi e c e was h e r e b e f o r e
10 | move [ 0 ] = l e t t e r T r a n s l a t e [ j ] ;
11 | move [ 1 ] = numberTranslate [ i ] ;

12 | } e l s e {
13 | // New pi e c e on t h i s p o s i t i o n
14 | move [ 2 ] = l e t t e r T r a n s l a t e [ j ] ;
15 | move [ 3 ] = numberTranslate [ i ] ;
16 | }
17 | }
18 | }
19 | }
20 | d ela y (2000 ) ;
21 | }

Takto pomocí dvou for loopu prochází hodnoty od nejvyšší po nejnižší. To je z důvodu

uložení dat a zapojení multiplexorů. Tam se postupně porovnává každé políčko s každým

dokud nenajde nějakou změnu. V případě, že všechny hodnoty jsou stejné jako předtím,

funkce se spustí z hlavního cyklu znovu. V případě změny však pomocí kódu detekujeme

zda šlo o změnu z 0 na 1 či naopak.

Změny z 0 na 1 Jelikož logická jednička označuje prázdné políčko, tato zmena značí

odkud se figurka přemístila. Zapíše se tedy do move na první a druhé pozici.

Změny z 1 na 0 Značí, že políčko bylo dříve prázdné a nyní se na něj umístila nová

figurka. Zapíše se tedy do list move na třetí a čtvrtou pozici

V momentě, kdy naplníme všechny čtyři místa v listu move, zruší se while cyklus v

hlavní funkci programu a kód může postupovat dále. Ve funkci máme na konci ještě dané

zpoždění, které zamezí chybám v detekci při pomalém přemísťování figurek.

## 3.3 Pohyb figurek na hracím poli

Realizaci šachových tahů nám zajištují dva krokové motory a elektromagnet. Pro účel

práce bylo nutné umožnit XY pohyb elektromagnetu uvnitř šachovnice. Soustavu bylo

nutné umístit dovnitř konstrukce a zajistit, aby byl elektromagnet velmi blízko PCB

desce a tím i figurkám.

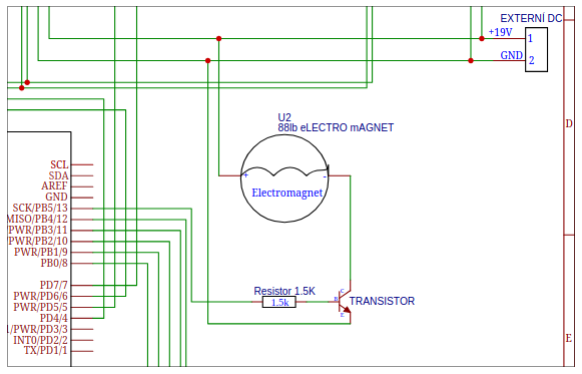
[picture p6: figure]

Obrázek 3.3: Ovládání elektromagnetu pomocí transistoru

### 3.3.1 Elektromagnet

Samotné přemístění figurky je realizováno pomocí elektromagnetu. Ten po přivedení

proudu vytvoří elektromagnetické pole, které začne působit na magnetickou šachovou

figurku nad ním, a tím s ní můžeme hýbat. Během tvorby řešení jsem musel zajistit, aby

elektromagnetické pole nebylo příliš velké a neovlivňovalo ostatní figurky. Zprvu ovšem

nastal jiný problém. Elektromagnet, i když zapnutý, nebyl schopen figurkou pohnout.

Tato situace nastala na základě faktu, že pro velkou účinost elektromagnetu je nutné

zminimalizovat prostor mezi elektromagnetem a přitahovaným tělesem. V situaci, kdy

jsem používal elektromagnet se silou 150N stále to nebylo dostatečné. Problém jsem vyřešil

vyvýšením elektromagnetu v konstrukci a zasazením jej blíže k plošnému spoji. Po těchto

úpravách mi postačil, elektromagnet se silou 50N. Avšak ani tento elektromagnet by s

figurkami nepohnul, jestliže by do nich nebyly umístěné magnetické prvky. Pokud bu do

figurky byla umístěna prostá ocel, nedokázal by jí elektromagnet přemístit.

Elektromagnet, který v práci využívám je v paremetrech u prodejce uváděn na 12V.

Já do něj však vysílám 18V z důvodu lepší spolehlivosti. Abychom však elektromagnet

mohli ovládat, musel jsem vymyslet způsob, jakým do elektromagnetu těchto 18V budu

vpouštět pouze po zaslání signálů. Na to využivám transistor. Transistor použitý v práci

po přivedení signálu na bázi, přepne vstup z kolektoru na emitor. Na kolektoru mám

přivedenou zem a po zaslání signálů na bázi, vyšlu zem skrze emitor do elektromagnetu.

Ten je z jeho druhého vstupu připojen k napětí a po přivedení země, začne působit. Po

ukončení signálu na bázi se elektromagnet vypne.

Kód, který transistor ovládá je velmi jednoduchý. Ve fuknci makeMove, o které budu

v dalších kapitolách hovořit, je boolovská proměnná magnetActivated. V případě, že mag-

net potřebuji nastavím jí jako true a pomocí podmínky v této funkci vyšlu na pin báze

transistoru (magnetPin) logickou jedničku. Na konci funkce po provedení pohyby, magnet

vždy vypínám.

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

### 3.3.2 Krokové motory

Pro zajištění pohybu využívám dva krokové motory NEMA17 s driverem A4988. Dri-

ver krokových motorů slouží jako mezikrok mezi programem a kódem a zajištuje pohodlné

ovládání motorů. Do těchto driverů přivádím po desce, jak 18V, tak 5V. Dále na nich na-

stavujeme směr pohybu a vysíláme signály, pomocí kterých pak motor hýbe s konstrukcí.

Pro zajištění správného pohybu bylo nutné zajistit dostačné napětí. To je dle specifi-

kací 8 až 35V. Po otestovaní jsem zjistil, že 18V bylo pro projekt ideální. Abych zamezil

přehřívání ovladačů, nalepil jsem na ně z vrchu chlazení, které je s nimi prodáváno.

Konstrukce

Konstrukce je realizována pomocí soustavy dvou motorů. Během řešení této problema-

tiky jsem se inspiroval tímto projektem[10]. První motor je umístěn zevnitř boční stěny

šachovnice. Na motor jsem umístil vhodnou řemenici a řemen natáhl na protější stěnu.

Zde jsem si ze dřeva sestrojil ústrojí pro další řemenici. Pod řemenem vedou tři vodicí tyče, do kterých jsem umístil druhý motor s konstrukcí. Řemen prochází touto konstrukcí

a při otáčení řemenice, tak pomocí řemenu pohybujeme na Y ose i s konstrukcí uvnitř ša-

chovnice. Vnitřní konstrukce je umístěna na třech ložiscích, kterými prochází vodící tyčí.

V této vnitřní dřevěné konstrukci je vyříznut otvor pro druhý krokový motor a zde je

postupováno podle podobného postupu. Vedou zde dvě vodicí tyče na X ose. Na těchto

vodicích tyčí jsou dvě ložiska, na která jsem si sestrojil dřevěnou plošinku připravenou pro

umístění magnetu. Magnet je na plošině vyvýšen pro zajištění spolehlivého přenosu figurek a kabely jsou vyvedeny na PCB desku. Na druhé straně je opět ústrojí pro řemenice

a řemen je proveden skrze plošinu s elektromagnetem.

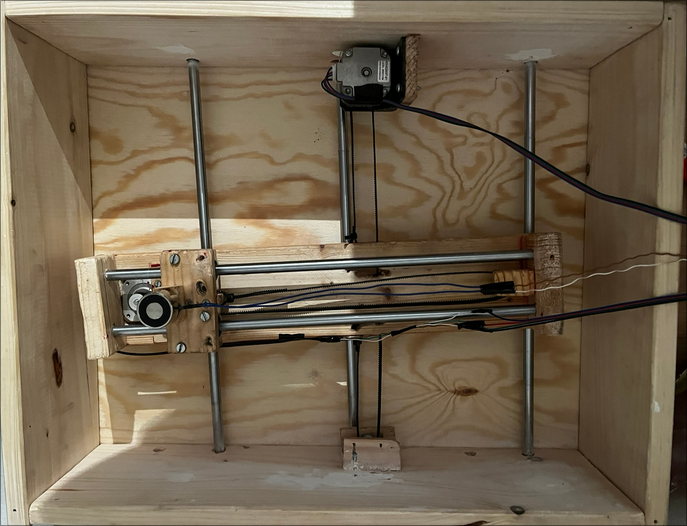
[picture p7: figure]

Obrázek 3.4: Konstrukce krokových motorů

Programový kód

Funkci, která ovládá motory jsem nazval moveMagnet. Tato funkce bere tři vstupní

parametry. Směr (direction) a vzdálenost (distance). Pro přehlednost nerozlišuje směry

pomocí if podmínek, ale pomocí switche. V něm nastavím, jaký blok kódu se provede,

jestliže směr bude odpovídat hodnotě za "case". Hodnota směru je dána jako pozice v

numerické klávesnici. Tedy 4 jako pohyb vlevo, 2 pohyb směrem dolů a např. 9 jako

diagonální pohyb doprava nahoru.

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

9 | d ela yMi c ro s e co n d s ( motorDelay ) ;
10 | d i g i t a lW r i t e ( stepPinX , LOW) ;
11 | d ela yMi c ro s e co n d s ( motorDelay ) ;
12 | }
13 | magnetX = magnetX − di s t a n c e ;
14 | break ;
15 | ca s e 9 :
16 | // Diagonal r i g h t up
17 | d i g i t a lW r i t e ( dirPinY , HIGH) ;
18 | d i g i t a lW r i t e ( dirPinX , HIGH) ;
19 | f o r ( i n t i = 0 ; i < boxLength ∗ di s t a n c e ; i++) {
20 | d i g i t a lW r i t e ( stepPinY , HIGH) ;
21 | d i g i t a lW r i t e ( stepPinX , HIGH) ;
22 | d ela yMi c ro s e co n d s ( motorDelay ) ;
23 | d i g i t a lW r i t e ( stepPinY , LOW) ;
24 | d i g i t a lW r i t e ( stepPinX , LOW) ;
25 | d ela yMi c ro s e co n d s ( motorDelay ) ;
26 | }
27 | magnetX = magnetX + di s t a n c e ;
28 | magnetY = magnetY + di s t a n c e ;
29 | break ;
30 | }
31 | // . . .

Samotný kód, který vysílá signály ovladači je v bloku pod case. Nejprve určíme směr po-

hybu. Buď logickou nulou či jedničkou. Následně začneme pomocí for cyklu vysílat pulzy

do motoru. Vždy nejdříve aktivujeme nutný stepPin. Pak zahájíme prodlevu. Tato prodleva nám určuje rychlost otáčení. Čím menší je, tím rychleji se motory točí. Poté stepPin

vypneme a znovu zahajíme prodlevu. Tento cyklus se opakuje podle žádané vzdálenosti,

kterou násobím délkou jednoho políčka.

### 3.3.3 Šachový tah

Algoritmus, který nám určuje tahy oponenta je udáván v tomto formátu: "e2e4" Tento

fakt nám velmi komplikuje proces tahu oponenta. Musíme totiž transformovat tento příkaz

do příkazu, kterému rozumí krokové motory.

Tuto transformaci provádíme ve funkcni makeChessMove. Ta má jako vstup daný set

znaků, který si přeloží do instrukcí. K překladu využíváme C funkcni strchr, které nám

udá pozici v listu. K ní pak přičteme jedničku a máme požadovanou X souřadnici tahu.

Pro "e"by to tedy bylo 5. Y souřadnici pouze změníme z textu na číslo tím, že od něj

odečteme textovou nulu.

1 | void makeChessMove ( cha r givenMove [ 5 ] ) {
2 | cha r a i L e t t e r T r a n s l a t e [ 8 ] = " abcde fgh " ;

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

6
7 | i n t toX = s t r c h r ( ai L e t t e r T r a n sl a t e , givenMove [ 2 ] )−a i L e t t e r T r a n s l a t e + 1 ;
8 | i n t toY = givenMove [ 3 ] − ’ 0 ’ ;
9 | // . . .

Následně tyto souřadnice předáme do funkce makeMove, kterou vystvělím v příští

kapitole. Než však přejdeme dále, musíme vysvětlit ještě jeden element šachového tahu

a to je braní figurek. V kódu braní realizujeme právě ve funkci makeChessMove. Pomocí

funkce isPlaceOccupied zjistíme zda jsou cílové souřadnice obsazené či volné.

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

V případě, že funkce vrátí true, musíme danou figurku odstranit. To provádíme tak, že ji

přesuneme mimo šachovnici neboli na 9. X souřadnici. Do funkce makeMove dáme nejprve

současné souřadnice magnetu a poté cílové, kde se náchází figurka. Poté, co elektromagnet

dosáhne souřadnic figurky, aktivujeme ho a přemístíme mimo hrací pole.

1 | i f ( t a ki n gPi e c e ) {
2 | // Moving p i e c e away
3 | makeMove (magnetX , magnetY , toX , toY , f a l s e ) ;
4 | makeMove ( toX , toY , 9 , 4 , t r u e ) ;
5 | }

Po těchto operacích teprve zahajíme požadovaný přesun figurky. Přemístíme magnet

z jeho současných souřadnic na souřadnice figurky, s kterou má pohnout a poté, co tam

dorazí aktivujeme elektromagnet a přemístíme magnet i s figurkou na souřadnice cílové.

1 | makeMove (magnetX , magnetY , fromX , fromY , f a l s e ) ;
2 | makeMove ( fromX , fromY , toX , toY , t r u e ) ;

Realizace tahu dle souřadnic

Abychom byli schopni zahrát šachový tah musíme ho transformovat do souřadnic. Zde

si vysvětlíme funkci, která tah realizuje.

Tato funkce se jmenuje makeMove a bere pět vstupních parametrů, XY souřadnice

odkud a kam a dále, zda má být elektromagnet zapnutý. Věc, kterou jsem určil tak,

aby se provedla jako první, je diagonální pohyb. Pomocí testování různých vztahů na

šachovnici, jsem přišel na vzorec, který nám určuje diagonální pohyb.

|y − targetY | == |targetX − x|

Jestliže v situaci vztah platí, provedeme diagonální pohyb na místo a ukončíme funkci

pomocí return. Ve funkci dále rozlišujeme pohyb diogonální doprava/doleva nahorů či

dolů. Jaký potřebujeme zjistíme porovnáním x a targetX.

1 | i f ( abs ( y − ta rge tY ) == abs ( ta rge tX − x ) ) {
2 | // Diagonal movement when moving p i e c e
3 | i f ( y > ta rge tY ) {
4 | // Diagonal down
5 | i f ( x < ta rge tX ) {
6 | // Right
7 | moveMagnet ( 3 , ta rge tX − x ) ;
8 | } e l s e {
9 | // L e f t
10 | moveMagnet ( 1 , ta rge tX − x ) ;
11 | }
12 | } e l s e {
13 | i f ( x < ta rge tX ) {
14 | // Right
15 | moveMagnet ( 9 , ta rge tX − x ) ;

16 | } e l s e {
17 | // L e f t
18 | moveMagnet ( 7 , ta rge tX − x ) ;
19 | }
20 | }
21 | r e t u r n ;
22 | }

Pokud pohyb dle souřadnic není diagonální, pohneme s figurkou po X či Y ose. Proces

je podobný jako předtím, akorát zde neaplikujeme vzorec ale pouze porovnáváme. Využí-

váme zde dřívě zmíněnou funkci moveMagnet, kterou dáváme jako požadovanou urazenou

vzdálenost rozdílem mezi x a targetX.

1 | // Move magnet to s t a r t i n g p o s i t i o n on X
2 | i f ( x < ta rge tX ) {
3 | // Move to r i g h t
4 | S e r i a l . p r i n t l n ( "moving r i g h t " ) ;
5 | moveMagnet ( 6 , x − ta rge tX ) ;
6 | } e l s e i f ( x > ta rge tX ) {
7 | // Move to l e f t
8 | moveMagnet ( 4 , ta rge tX − x ) ;
9 | }

## 3.4 Algoritmus vytvořeného programu

Algoritus pro šachovou hru se odehrává v hlavním cyklu programu. V této části práci si

vystvětlíme, jak probíhá od samotného spuštění, po tvorbu tahů oponenta, až po ukončení

hry.

### 3.4.1 Variablizace hry

To realizujeme pomocí pátého kontrolního multiplexoru. Tento multiplexor má pouze

pět spínačů, a to

První dva spínače Hra za bílé či černé figurky

Další tři Tyto spínače slouží pro zvolení obtížnosti hry.

V kódu variabilazaci sledujeme pomocí podmínek ve funkci setControlMux, která se volá

hned na začátku hry. Nejprve přečteme hodnoty spínačů, poté určíme parametry. V mo-

mentě, kdy uživatel zvolil barvu a jeden ze spínačů obtížnosti je spuštěný, zahájíme hru

přepnutím proměnné gameStarted na true.

1 | void setControlMUX ( ) {
2 | ge tReedValues ( muxEnable [ 4 ] , 0 , 8 ) ;
3 | memcpy ( co n t rolVal u e s , recordedReedValue , s i z e o f ( c o n t r ol V al u e s ) ) ;

4
5 | // S e t ti n g the data based on MUX wi ri n g
6 | i f ( ! c o n t r ol V al u e s [ 1 ] ) {
7 | playingAsWhite = f a l s e ;
8 | }
9 | // . . .
10 | i f ( ! c o n t r ol V al u e s [ 5 ] ) {
11 | d i f f i c u l t y = 2 ;
12 | }

13
14 | i f ( ( ! c o n t r ol V al u e s [ 1 ] | | ! c o n t r ol V al u e s [ 2 ] ) &&
15 | ( ! c o n t r ol V al u e s [ 3 ] | | ! c o n t r ol V al u e s [ 4 ] | | ! c o n t r ol V al u e s [ 5 ] ) ) {
16 | gameStarted = t r u e ;
17 | }

### 3.4.2 Průběh hry

V hlavním cyklu programu, po splnění proměnné gameStarted probíhá hra. Kód v

cyklu primárně využívá již výše popsané funkce. Zde si ukážeme jejich aplikaci. Nejprve

získáme hodnoty spínačů pomocí setCurrentBoard, následně tyto hodnoty uložíme do

paměti a spustíme detekci pohybu. V případě, že uživatel hraje za bílé figurky, spustí

se funkce detectBoardMovement a běží až do doby, kdy hráč s nějakou figurkou pohne.

Tento pohyb se uloží do proměnné move, a ta se předá MiniMax algoritmu pro šachovou

hru. Ten rozeberu dále v práci.

1 | // Pla y e r ’ s tu rn => wai ti ng f o r movement
2 | se tCu r ren tBoa rd ( ) ;
3 | memcpy ( boardValuesMemory , boardValues , s i z e o f ( boardValuesMemory ) ) ;
4 | w hil e ( ! move [ 0 ] | | ! move [ 1 ] | | ! move [ 2 ] | | ! move [ 3 ] ) {

5 | detectBoardMovement ( ) ;
6 | }

7
8 | // AI tu rn
9 | getAIMove (move ) ;

MiniMax vyhodnotí zda, byl tah uživatele validní a následně zda je hra u konce či ještě

pokračuje. V případě, že tah nebyl validní, což se může stát chybou uživatele a přepnutím

jiných spínačů, to vyřešíme resetem tahu.

1 | i f ( ! validMove ) {
2 | // I f u s e r made i n v a l i d move
3 | // R e s s e ti n g move
4 | move [ 0 ] = 0 ;
5 | move [ 1 ] = 0 ;
6 | move [ 2 ] = 0 ;
7 | move [ 3 ] = 0 ;
8 | r e t u r n ;
9 | }

Dále nám algoritmus vrátí ideální tah pro oponenta uložený pod externí proměnnou

lastMoveAi. Ta obsahuje šachový tah, v šachovém formátu. V práci jsem již implementoval

řešení funkční makeChessMove. Tuto funkci zde zavoláme a tah se provede. Po provedení

tahu opět vyresetujeme proměnnou move a cyklus spustíme od začátku.

1 makeChessMove ( lastMoveAI ) ;

### 3.4.3 Možnost hry s protihráčem

Šachovou hru s protihráčem realizujeme pomocí MiniMax algoritmu. Tento šachový

algoritmus od pana H. G. Mullera [11]. Program je dostupný pod Open source licencí a

pro Arduino ho přepsal pan Diego Cueva. Tento algoritmus jsem objevil v jedné realizaci

projektu šachovnice [9] a jeho využití jsem si přepsal pro své potřeby.

Kód pro algoritmus je v odlišném souboru, a to v MiniMax.h a MiniMax.cpp. Samotný

kód algoritmu je extrémně optimalizován za účelem nejvyšší možné efektivity a délky.

Jména proměnných i funkcí jsou zde zkracována, na co nejkratší a kód je díky tomu těžko

srozumitelný. Z prvu v kódu nastavíme hodnoty pro šachové figurky.

1 | cha r L , w [ ] = {0 , 2 , 2 , 7 , −1, 8 , 12 , 23} , /∗ r e l a t i v e p i e c e v al u e s | ∗/
2 | o [ ] = {−16, −15, −17, 0 , | 1 , | 16 , 0 , | 1 , 16 ,
3 | 15 , | 17 , | 0 , | 14 , 18 , 31 , 33 , 0 , /∗ s tep−v e c t o r l i s t s ∗/
4 | 7 , | −1, | 11 , | 6 , | 8 , | 3 , | 6 , | /∗ 1 s t d i r . i n o [ ] pe r p i e c e ∗/
5 | 6 , | 3 , | 5 , | 7 , | 4 , | 5 , | 3 , | 6 }; /∗ i n i t i a l p i e c e se tup | ∗/
6 | /∗ board i s l e f t part , c e n t e r−p t s t a b l e i s r i g h t part , and dummy ∗/

Kód pokračuje sekcí výpočtu MiniMaxu na základě parametrů pro výhru oponenta.

Tento výpočet je velmi koplikovaný a na stránkách pana Mullera uvedených ve zdrojích

vysvětlený dopodrobna. Já zde vysvětlím části, které byli důležité pro projení s mým

kódem.

Důležitá je zde funkce getAiMove, která má za vstup šachový tah. Algoritmus si tah

rozebere a provede opět výpočet. Zde můžeme upravit obtížnost pod proměnnou v kódu

určenou jako velké T. Dále je pro nás důležitý status hry. Ten ukládáme do externí pro-

měnné z hlavního souboru gameStatus, kde ji kontrolujeme. V případě výhry ji stanovíme

na 2 a v případě prohry na 1.

1 | i f ( ! ( r > −I + 1 ) ) {
2 | S e r i a l . p r i n t l n ( "Lose " ) ;
3 | gameStatus = 1 ;
4 | }

Poslední částí, kterou bych chtěl zmínit je funkce, která zvaliduje a překopíruje daný

šachový tah do proměnné lastMove. Zárověn ještě stanoví validMove, což nám určuje zda

byl pohyb legální.

1 | s t r c p y ( lastMove , c ) ; /∗ Valid human movement ∗/
2 | validMove = t r u e ;

## 3.5 Mechanické provedení

Šachovnici bylo zapotřebí umístít do pevného krytu, který bude elektrické součástky

chránit před poškozením. Já jsem se rozhodl pro dřevo. Dřevo bylo pro mě volba z důvodu

dobrých možností úprav a opracování. Dále se mi také velmi zamlouvalo zachovat dojem

klasické šachovnice, která je bězně také dřevěná. Box se skládá ze čtyř zakladních dřevěn-

ných desek. Ze shora a ze spoda je šachovnice uzavřena tenkými překližkami. Samořídící

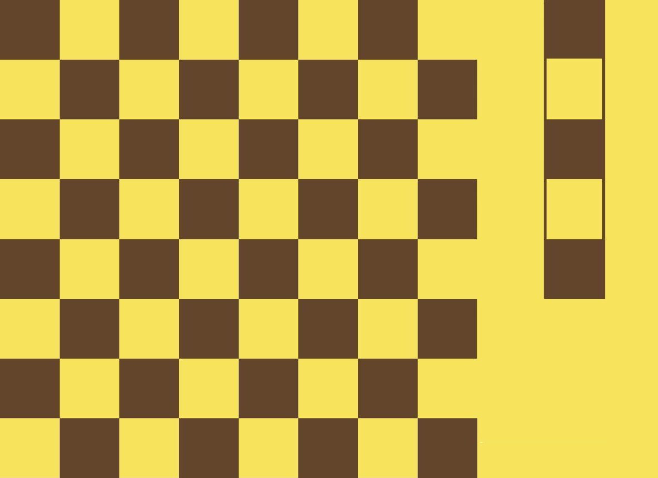
[picture p8: figure]

Obrázek 3.5: Návrh vzhledu herní části šachovnice

šachovnici jsem v závěru projektu nalakoval ochranou vrstvou.

Horní překližka má v sobě zasazenou PCB desku. Ta je do ní připevněna pomocí 8

šroubů, které zárověn společně s cínem drží oba kusy desky pohromady. Do desky jsou

vyvedeny kabely od motoru a elektromagnetu. Napajení je realizováno bočním otvorem

do šachovnice a připevněno dřevěnou destičkou.

### 3.5.1 Herní část šachovnice

Pro vzhled šachovnice jsem si v programu Pinta vytvořil návrh šachových políček. Na

pravou část návrhu jsem umístil kontrolní spínače pro volbu hry. Návrh jsem si nechal

vytisknout na pevný papír, jenž jsem na desku přilepil. Pro šachovnici jsem si nechal

vytisknout vhodné šachové figurky pomocí 3D tisku a do nich vložil malé magnety.

# Kapitola 4

# Závěr

Samořídící šachovnice byla v rámci práce zrealizována. Umožnuje šachovou hru proti

oponentovi, kterého simuluje algoritmus.
Šachovnice je schopna detekovat figurky umístěné na jejím herním poli. Jako řešení

byla vyrobena deska plošného spoje s potřebnými součástkami. Deska obsahuje 69 mag-

netických spínačů, které skrze multiplexory čteme pomocí řídící jednotky. Jako řídící jed-

notku jsem si zvolil Arduino UNO, které dostatečně plní všechny potřebné úlohy práce.

Pro účely řízení jsem vytvořil program, který je schopen ovládat všechny potřebné

části šachovnice. Program je schopen řešit situace, které během hry mohou nastat. Dokáže

zařídit odpověd na šachový tah hráče, který rozpozná na základě sepnutí spínačů. Pro

tento účel využívá algoritmus MiniMax, který pomocí výpočtů zjistí ideální odpovídající

tah. Následně tento tah transformuje do signálů, které jsou schopné vykonat krokové

motory a přemístí požadovanou šachovou figurku na odpovědné místo.

Samořídící šachovnici jsem zkonstruoval do dřevěné skříně, ve které jsou umístěny

všechny potřebné prvky. Je do ní z boční strany přivedeno odpovídající napětí. Toto

napětí nám stabilizátor umožní variovat pro motory, eletromagnet a ostatní součástky.

Dovnitř šachovnice jsem sestrojil sestavu krokových motorů, která je schopna provádět

pohyb po XY souřadnicích. Tento mechanismus je sestrojen pomocí umístění vnitřní plo-

šiny na vodicí tyče v konstrukci. Touto plošinou je proveden řemen zakončený řemenicí.

Na horizontální ose je podobný mechanismus. Je na ní však použit elektromagnet, který

pohybuje s figurkami.

Pro projekt jsem zařídíl šachové figurky vytvořené pomocí 3D tisku, do kterých jsem

umístil malé magnety. Návrh pro herní pole jsem vytvořil a následně ho nechal vytisknout

na vhodný materiál. Ten je připevněný na desku plošného spoje.

# Seznam obrázků

2.1 Rozlišení SMT a THT na PCB desce | 11
2.2 Minimax algoritmus | 13
3.1 porovnání PCB desky z výroby a osázené | 15
3.2 Zapojení magnetických spínačů na desce | 18
3.3 Ovládání elektromagnetu pomocí transistoru | 24
3.4 Konstrukce krokových motorů | 27
3.5 Návrh vzhledu herní části šachovnice | 35

# Příloha A

# schema_sachovnice.pdf

# Literatura

[1] conrad.cz. Arduino® » Praktický mikrokontrolér pro individuální spínací a

řídicí úlohy. https://www.conrad.cz [online]. ©2024 [cit.29. 2. 2024]. Dostupné z:

https://www.conrad.cz/cs/clanky/elektromechanika/arduino.html?srsltid=AfmBOoq-

DVdYd1lkV0hVguOg5cvqM7O721czoRtYbZBji4hT3SLgxRoY

[2] botland.cz. Deska PCB – co to je?. https://botland.cz/ [online]. ©2023 [cit.13. 3.

2023]. Dostupné z: https://botland.cz/blog/deska-pcb-co-to-je/

[3] uk.rs-online.com. reed-switches-guide. https://uk.rs-online.com [online]. ©2023

[cit.1. 2. 2023]. Dostupné z: https://uk.rs-online.com/web/content/discovery/ideas-

and-advice/reed-switches-guide

[4] dubno.cz. | VY_32_INOVACE_CTE_2.MA_13_Multiplexory.
https://dubno.cz/ | [online]. | ©2012 | [cit.1.8.2012]. | Dostupné | z:

https://dubno.cz/images/stories/dum/8.sablona/24/pdf/

VY_32,_INOVACE_CTE_2.MA_13_Multiplexory.pdf

[5] wikipedia.cz. | Stabilizátory | napětí. | https://www.wikipedia.cz
[online]. | ©2024 | [cit.22.2.2024]. | Dostupné | z:

https://cs.wikipedia.org/wiki/Stabiliz%C3%A1tor_nap%C4%9Bt%C3%AD

[6] lastminuteengineers.com. | 28byj48-stepper-motor-arduino-tutorial/.
https://lastminuteengineers.com [online]. | ©2025 [cit.23. 3. 2025]. | Dostupné z:

https://lastminuteengineers.com/28byj48-stepper-motor-arduino-tutorial/

[7] cs.wikipedia.org. Elektromagnet. https://cs.wikipedia.org/ [online]. ©2025 [cit.25.
1. 2025]. Dostupné z: https://cs.wikipedia.org/wiki/Elektromagnet
[8] geeksforgeeks.com. | mini-max-algorithm-in-artificial-intelligence.
https://www.geeksforgeeks.org/ [online]. | ©2024 [cit.27.8.2024]. | Dostupné z:

https://www.geeksforgeeks.org/mini-max-algorithm-in-artificial-intelligence/

[9] https://www.instructables.com. | Automated-Chessboard.
https://www.instructables.com [online]. | ©2022 [cit.2.1.2022]. | Dostupné z:

https://www.instructables.com/Automated-Chessboard/

[10] https://projecthub.arduino.cc. | maguerero/automated-chess-board-67db6f.
https://projecthub.arduino.cc [online]. | ©2018 [cit.24.10.2018]. | Dostupné z:

https://projecthub.arduino.cc/maguerero/automated-chess-board-67db6f/

[11] home.hccnet.nl. /h.g.muller/max-src2. https://home.hccnet.nl/ [online]. ©2025

[cit.25.3.2025]. Dostupné z: https://home.hccnet.nl/h.g.muller/max-src2.html

[12] pcba-manufacturers.com. | SMT vs THT. | 2023 [online]. | ©23. 3. 2023

[cit.https://www.pcba-manufacturers.com/smt-vs-tht/]. Dostupné z:

[13] store.arduino.cc. | Arduino UNO pinout. | 2025 [online]. | ©19. 3. 2025

[cit.https://store.arduino.cc/en-cz/products/arduino-uno-rev3]. Dostupné z:

[14] https://www.tpointtech.com. | minimax-algorithm-in-python.
https://www.tpointtech.com/ [online]. | ©2025 [cit.23.3.2025]. | Dostupné z:

https://www.tpointtech.com/minimax-algorithm-in-python
