realWalter05/automated_chess/docs/MetodickýPokyn/InformačníTechnologie_TitulníStrana.docx

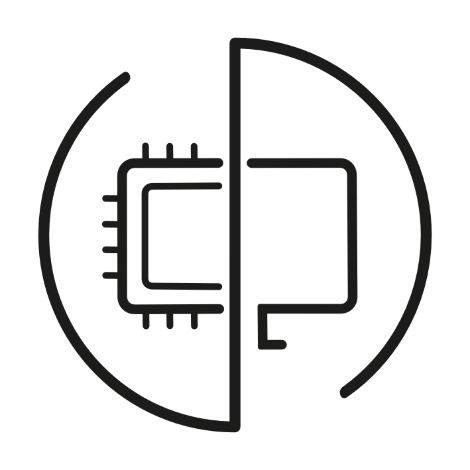
[picture p9: figure]
Obsah obrázku symbol, klipart, diagram, skica Popis byl vytvořen automaticky

Střední průmyslová škola a Vyšší odborná škola, Písek,

Karla Čapka 402

397 11 Písek

Školní rok: 2024/2025

Obor vzdělání: 18-20-M/01 Informační technologie

Maturitní práce

Název práce

Téma číslo:

Jméno žáka:

Třída:

Vedoucí práce:
