realWalter05/automated_chess/soc/socPrilohy/A.2_navrh_herniho_pole.pdf

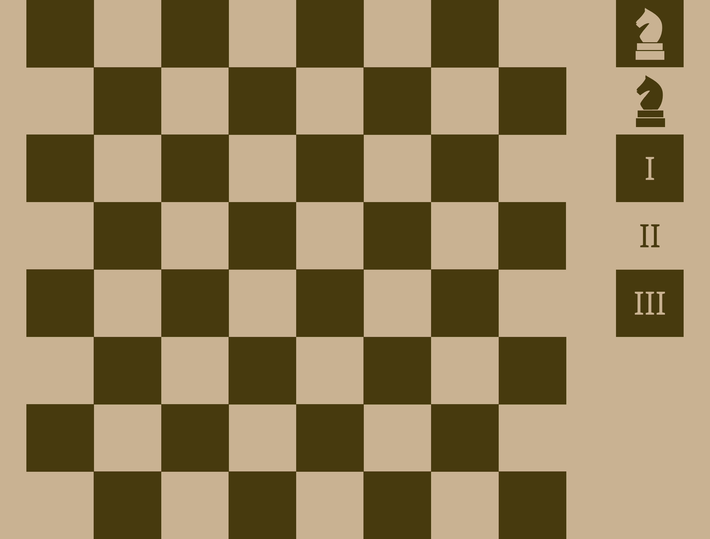
[picture p10: figure]
III
