realWalter05/automated_chess/docs/latex/images/chessStickerCropped.jpg

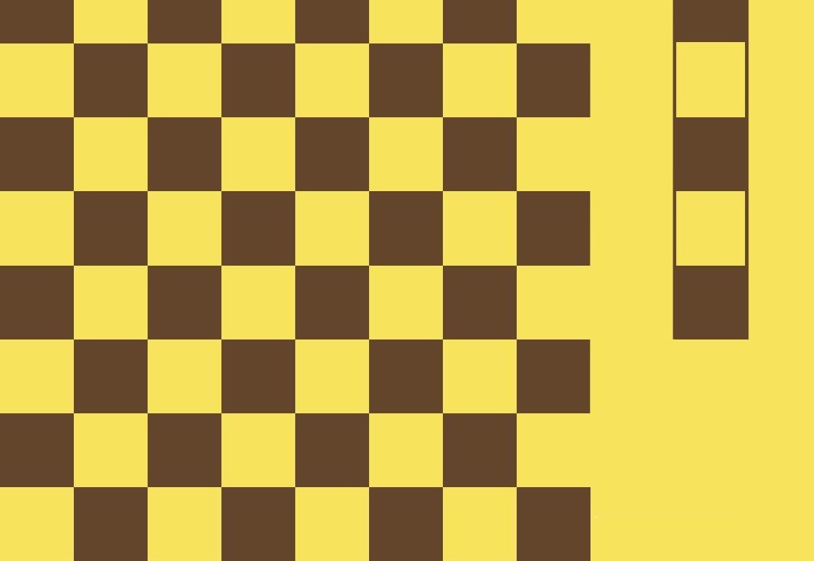
docs/latex/images/chessStickerCropped.jpg
