realWalter05/automated_chess/docs/latex/images/pcb_SMT_THT.png

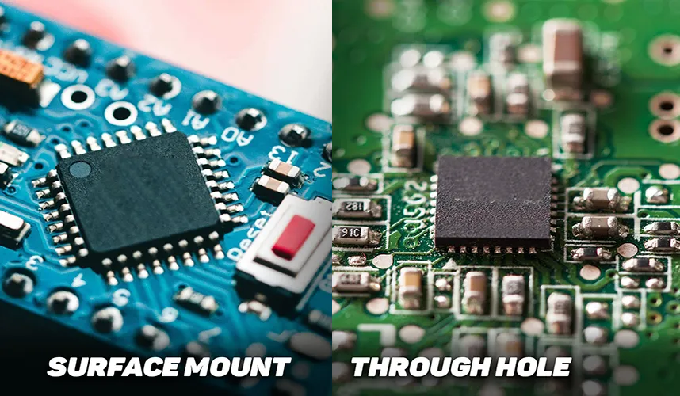
docs/latex/images/pcb_SMT_THT.png
