realWalter05/automated_chess/docs/latex/images/sachovnice.jpg

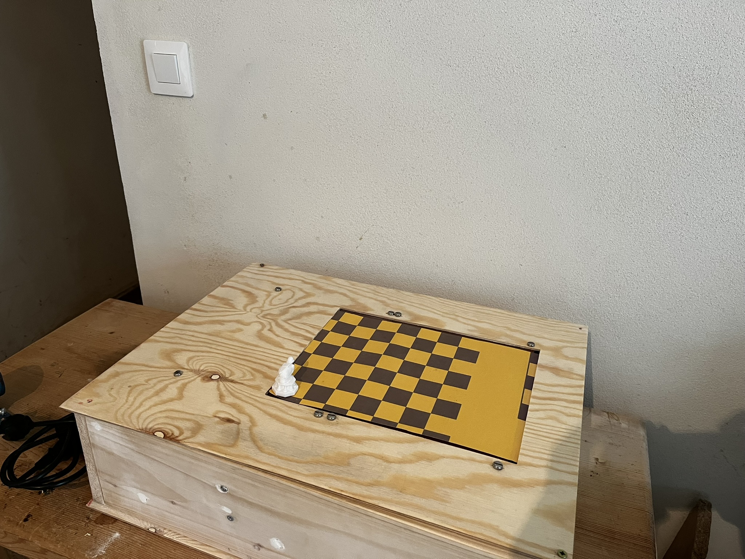
docs/latex/images/sachovnice.jpg
