realWalter05/automated_chess/docs/latex/images/schema_easyADA.png

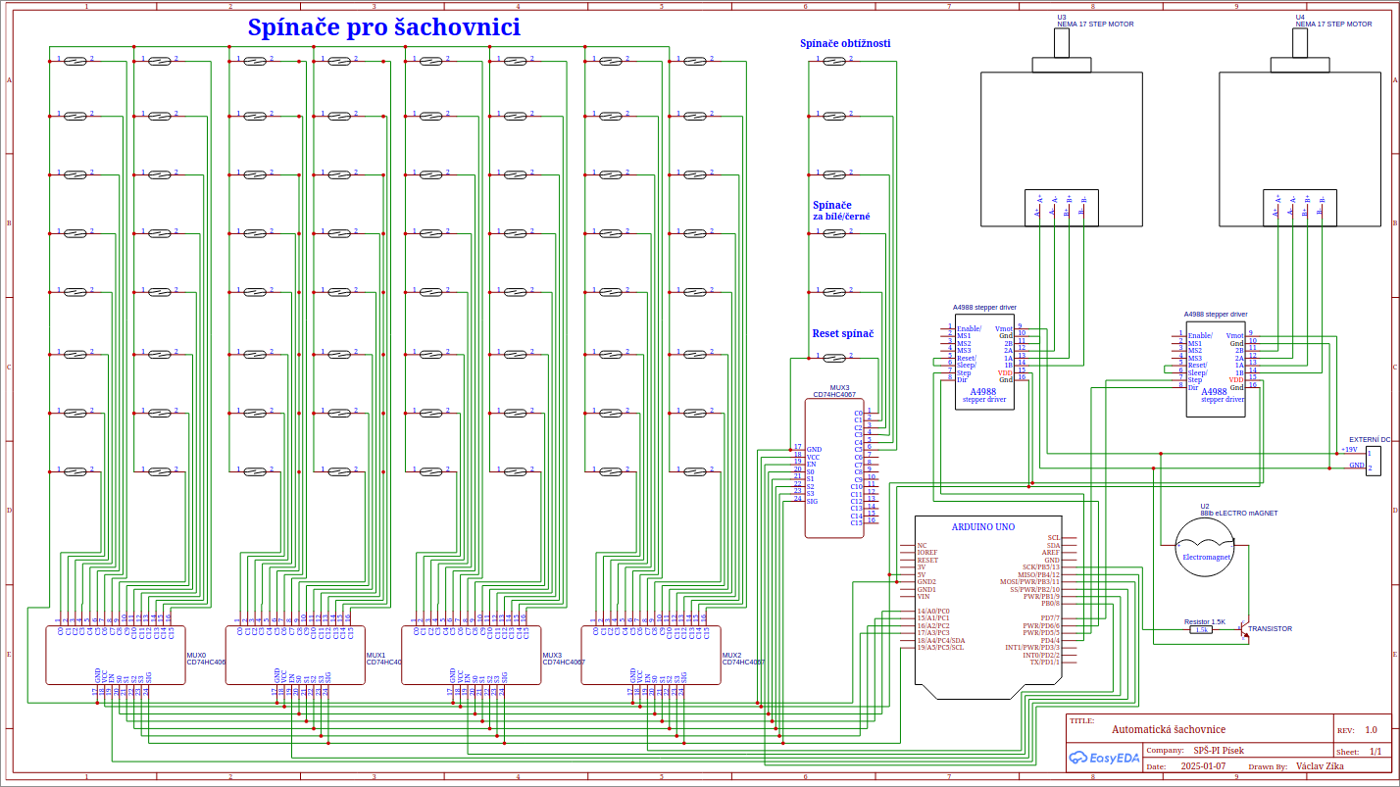
docs/latex/images/schema_easyADA.png
