realWalter05/automated_chess/docs/latex/images/transistor.png

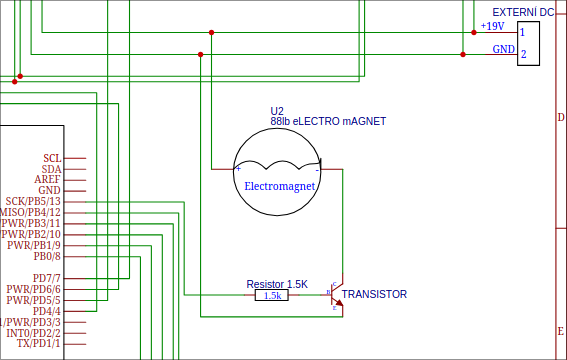
docs/latex/images/transistor.png
