realWalter05/automated_chess/soc/Automatické šachy.png

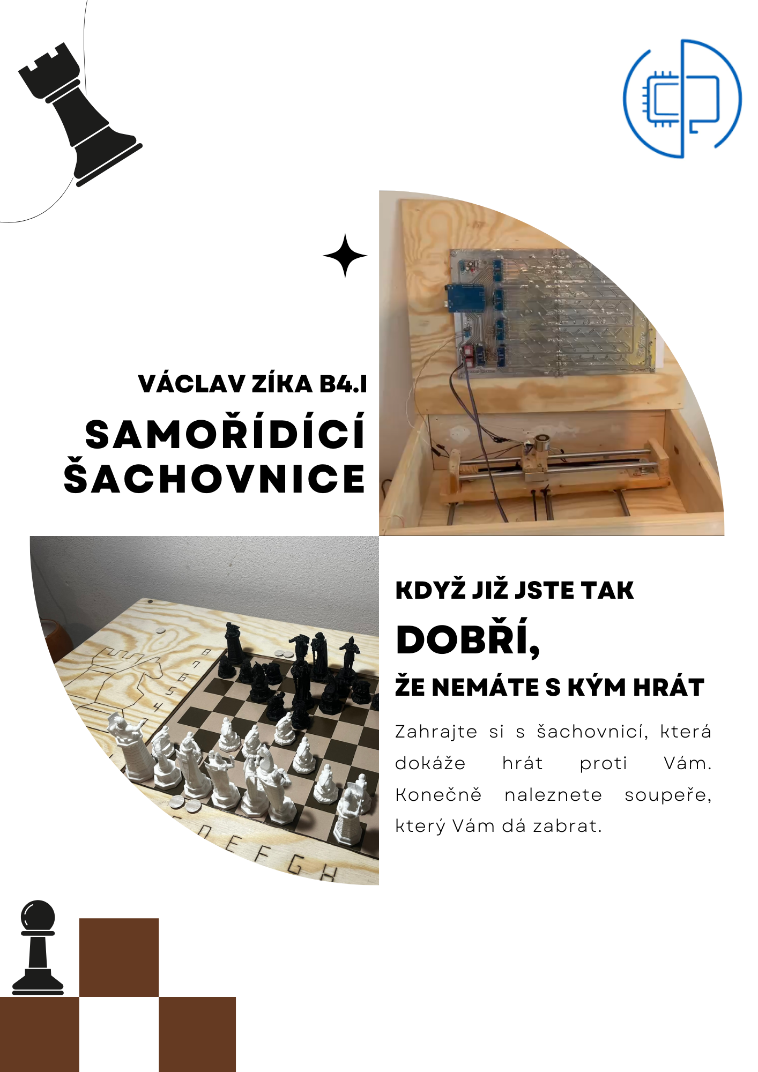
soc/Automatické šachy.png
