realWalter05/automated_chess/3dtisk/provaska/jezdec_v2.stl

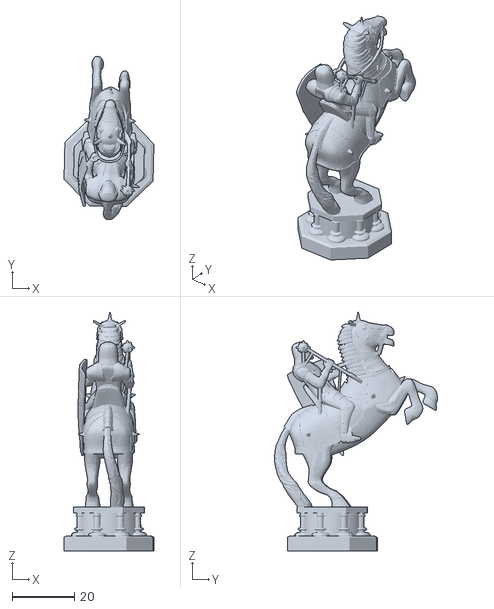
[picture p17: CAD file, 2025-04-02]
3dtisk/provaska/jezdec_v2.stl
28.8 x 52.4 x 76.7
