realWalter05/automated_chess/3dtisk/vez.stl

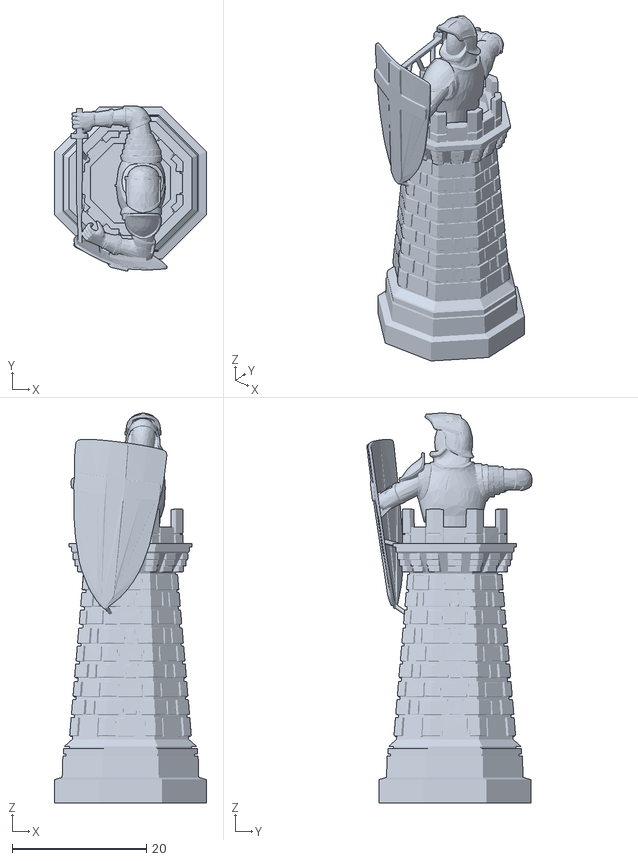
[picture p18: CAD file, 2025-04-02]
3dtisk/vez.stl
22.7 x 24.6 x 58.1
