realWalter05/automated_chess/3dtisk/dira.stl

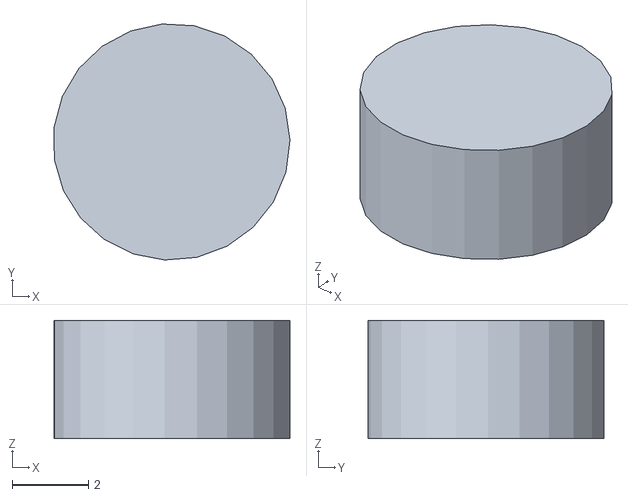
[picture p19: CAD file, 2025-04-02]
3dtisk/dira.stl
6.19 x 6.19 x 3.10
