realWalter05/automated_chess/3dtisk/provaska/vez_v2.stl

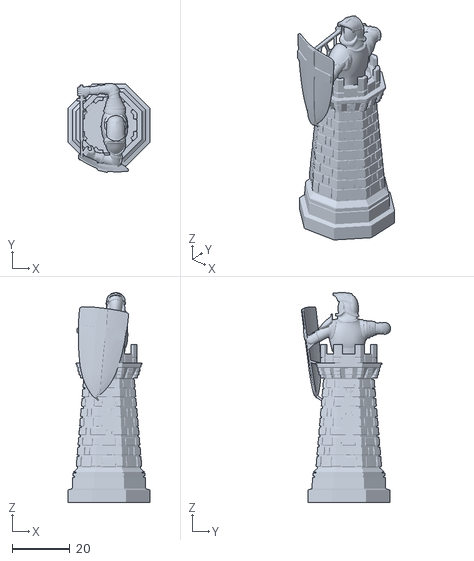
[picture p20: CAD file, 2025-04-02]
3dtisk/provaska/vez_v2.stl
28.5 x 31.0 x 73.0
