realWalter05/automated_chess/3dtisk/kralovna.stl

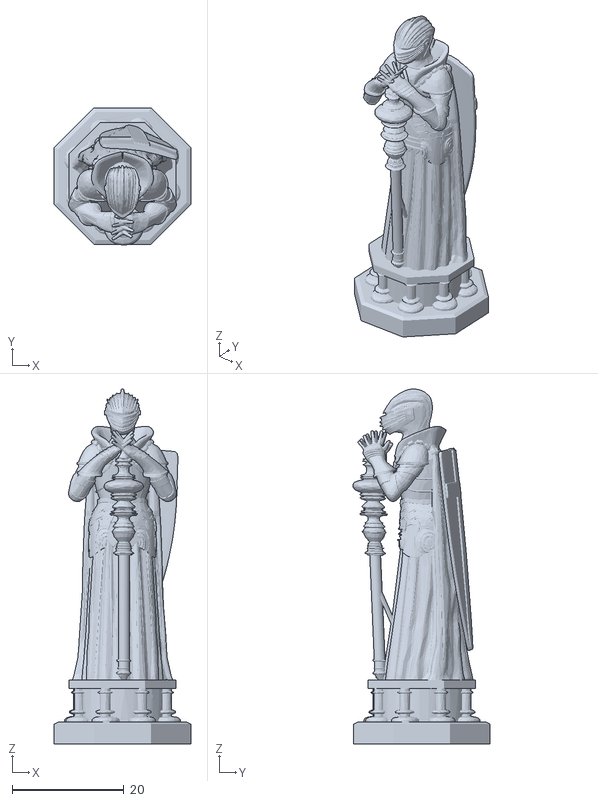
[picture p21: CAD file, 2025-04-02]
3dtisk/kralovna.stl
24.5 x 24.6 x 63.7
