realWalter05/automated_chess/3dtisk/provaska/pesak.stl

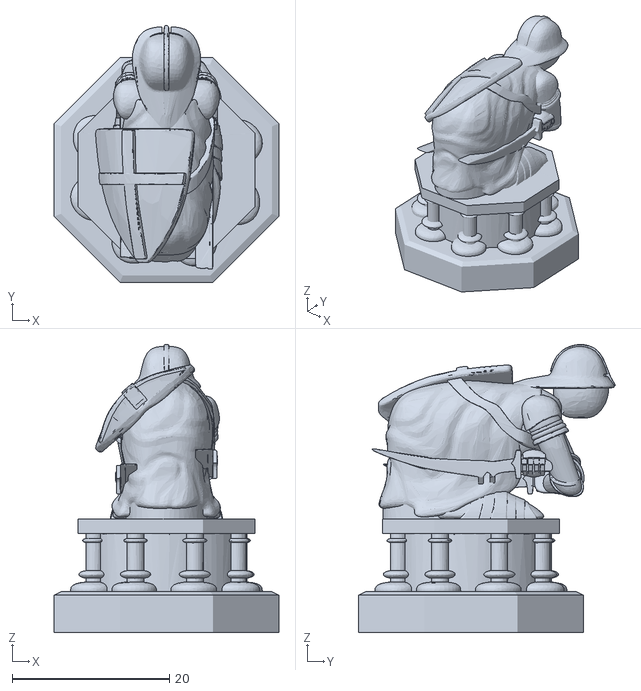
[picture p22: CAD file, 2025-04-02]
3dtisk/provaska/pesak.stl
28.6 x 32.7 x 36.6
