realWalter05/automated_chess/3dtisk/provaska/kralovna.stl

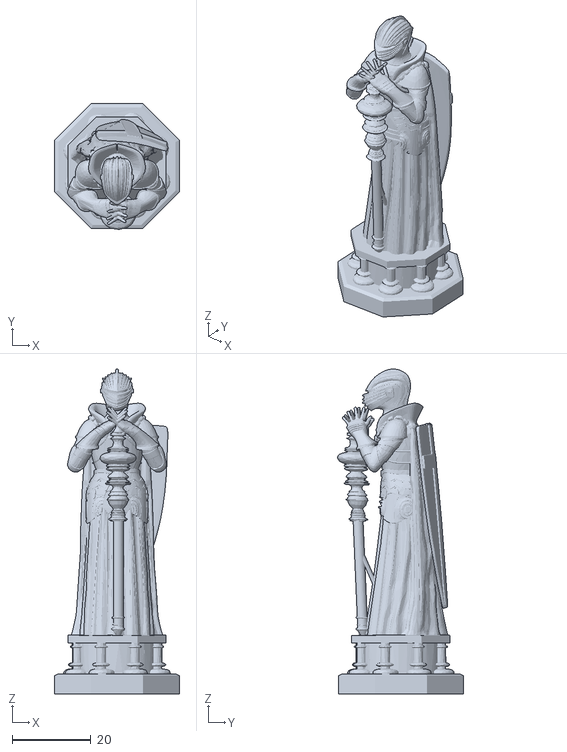
[picture p23: CAD file, 2025-04-02]
3dtisk/provaska/kralovna.stl
31.8 x 32.0 x 82.5
