realWalter05/automated_chess/3dtisk/strelec.stl

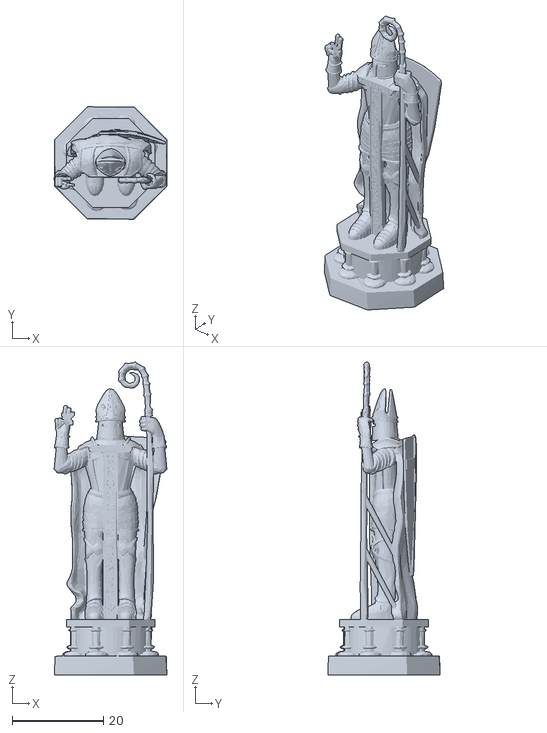
[picture p24: CAD file, 2025-04-02]
3dtisk/strelec.stl
24.8 x 24.7 x 68.6
