realWalter05/automated_chess/3dtisk/pesec.stl

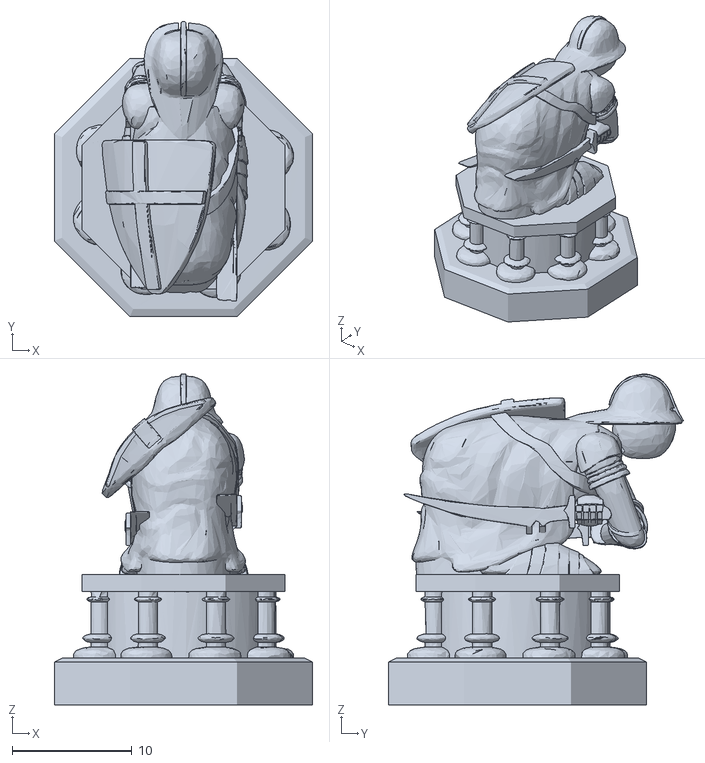
[picture p25: CAD file, 2025-04-02]
3dtisk/pesec.stl
21.6 x 24.7 x 27.6
