realWalter05/automated_chess/3dtisk/provaska/knez.stl

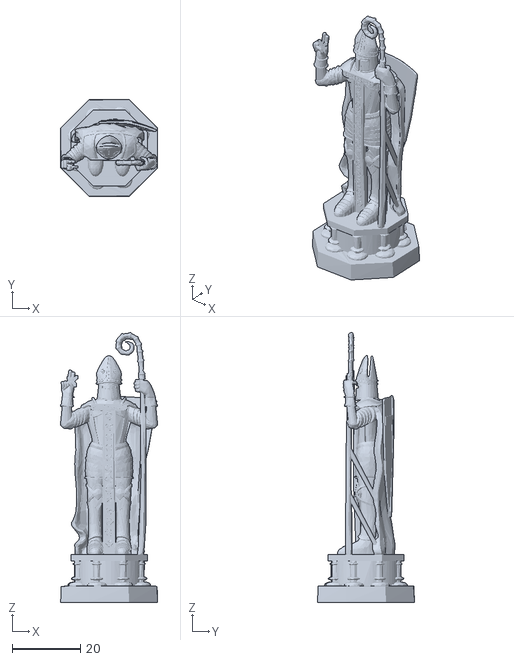
[picture p26: CAD file, 2025-04-02]
3dtisk/provaska/knez.stl
28.5 x 28.4 x 78.9
