realWalter05/automated_chess/(list of files, cad)

Other CAD files:
3dtisk/provaska/vez.stl
3dtisk/provaska/jezdec.stl
