realWalter05/automated_chess/docs/manual/LaTeX_Task/task.tex

\documentclass[a4paper, 12pt]{report}
\usepackage{monapack}

\student{Jméno Příjmení}
\trida{Třída}
\obor{Kód oboru Název oboru}
\vedouci{Titul, jméno a příjmení}
\nazevPrace{Název práce}
\cisloPrace{Číslo}
\skolniRok{Školní rok}
\reditel{Titul, jméno a příjmení}

\zacatek

\zadani{DD. MM. RRRR}
{
	\bod
	\bod
	\bod
	\bod
}
{
	\bod
	\bod
	\bod
}
{
	\bod
	\bod
	\bod
}
{škola/firma/žák}
{školy/firmy/žáka}
{DD. MM. RRRR}

\konec
