realWalter05/automated_chess/docs/manual/LaTeX_Template/document.tex

\documentclass[a4paper, 12pt]{report}
\usepackage{monapack}

\student{Jméno Příjmení}
\trida{Třída}
\obor{Kód oboru Název oboru}
\bydliste{Adresa bydliště}
\datumNarozeni{Datum narození}
\vedouci{Titul, jméno a příjmení}
\nazevPrace{Název práce}
\cisloPrace{Číslo}
\skolniRok{Školní rok}
\reditel{Titul, jméno a příjmení}

\zacatek
	
	\titulniStrana

	\zadani{DD. MM. RRRR}
	{
		\bod
		\bod
		\bod
		\bod
	}
	{
		\bod
		\bod
		\bod
	}
	{
		\bod
		\bod
		\bod
	}
	{škola/firma/žák}
	{školy/firmy/žáka}
	{DD. MM. RRRR}
	
	\anotace 
	Text

	\annotation
	Text
	
	\podekovani
	Text
	
	\licencniSmlouva{DD. MM. RRRR}
	
	\obsah
	
	\kapitola{Úvod}
	\kapitola{Vlastní text práce}
		rozvedený do jednotlivých kapitol a subkapitol
		\podkapitola{Subkapitola}
			\podpodkapitola{Subsubkapitola}
	\kapitola{Závěr}

	\seznamTabulek
	
	\seznamObrazku
	
	\prilohy{
		\kapitola{Příloha}
	}
	
	\literatura{
		
		\kniha{nazevCitace}{Příjmení autora}{Jméno autora}{Název knihy}{Místo vydání}{Nakladatelství}{Rok}{ISBN}
		
		\kvalifikacniprace{nazevCitace}{Příjmení autora}{Jméno autora}{Název práce}{Místo}{Rok}{Druh práce}{Univerzita, Fakulta, Katedra}{Vedoucí diplomové práce jméno}
		
		\url{nazevCitace}{Název stránek}{Titulek}{Stránky}{rok}{datum}{URL odkaz}
		
	}
	
\konec
