realWalter05/automated_chess/docs/manual/LaTeX_Dokumentace/document.pdf

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

Zp·sob zpracování a pokyny k obsahu a rozsahu maturitní práce

Práce bude zpracována podle platného metodického pokynu dostupného na

n:\!maturita\MetodickýPokyn\...).

Kompletní práce se odevzdává do informa£ního st°ediska ²koly v jednom ti²t¥ném exem-

plá°i dopln¥ném elektronickým nosi£em dat (CD, DVD, USB ash disk, SD karta), na kte-

rém bude uvedena kompletn¥ zpracovaná práce v£etn¥ p°íloh. V p°ípad¥ tvorby software,

také zdrojový kód navrºeného software. V p°ípad¥ projektu, také projektová dokumentace

(podrobná technická zpráva, úplná výkresová dokumentace, podrobný rozpo£et).

Náklady na materiál bude hradit ºák.

Funk£ní vzorek bude majetkem ºáka.

V Písku 15. 11. 2017

Ing. Ji°í Uhlík
°editel SP a VO Písek

## Anotace

Tato maturitní práce p°edstavuje ²ablonu vytvo°enou pro tvorbu dlouhodobé maturitní

práce v sázecím systému LATEX. Zahrnuje p°ipojený balík monapack obsahující nadeno-

vaný styl a formátování textu maturitní práce a to v²e za dodrºení typograckých pravidel.

Sou£ástí této dokumentace je podrobný manuál pro pohodlné pouºití ²ablony.

Klí£ová slova: LATEX, dokumentace, ²ablona, balík

## Annotation

This graduation work presents a template made for creation of long-term graduation work

in LATEX. It includes package monapack containing dened style and formatting of text

for graduation work, while abiding the typography rules. Part of this documentation is

detailed manual for comfortable application of the template.

Key words: LATEX, documentation, template, package

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
# Kapitola 2

# Instalace

Pro sazbu textu v systému LATEX je pot°eba nainstalovat sázecí prost°edí (nap°. TEXstudio)

spole£n¥ s LATEXovou distribucí, v na²em p°ípad¥ s MiKTEXem. Na po°adí instalace distri-

buce a prost°edí nezáleºí. Je zcela libovolné, která instalace se aplikuje jako první v po°adí

a která jako druhá.

## 2.1 Instalace produktu TEXstudio

Na ociálních stránkách texstudio.org je k dispozici ke staºení software TEXstudio. P°i

spu²t¥ní instalace se povolí, aby následující program provedl zm¥ny v po£íta£i. Zvolí se cí-

lové umíst¥ní, kam má být produkt TEXstudio nainstalován a klikne se na tla£ítko Dal²í.

Vyberou se dal²í úlohy, které mají být provedeny v pr·b¥hu instalace, a pokra£uje se

klepnutím na tla£ítko Dal²í.

Pr·vodce instalací je nyní p°ipraven naistalovat produkt TEXstudio na po£íta£. Instalace

se potvrdí klepnutím na tla£ítko Instalovat. Po chvilce je instalace tém¥° u konce a zvo-

lením moºnosti Dokon£it se spustí sázecí prost°edí softwaru TEXstudio.

Pokud je nejprve nainstalováno TEXstudio p°ed MiKTEXem, zobrazí se upozorn¥ní, ºe

nebyla nalezena ºádná LATEXová distribuce. To znamená, ºe odpovídající p°íkazy nejsou

nastaveny, a proto je nebude moºné p°ekládat do poºadovaného výstupního formátu (nap°.

PDF).

## 2.2 Instalace sázecího systému MiKTEX

Po rozkliknutí polí£ka Download v horním panelu webových stránek miktex.org se vybere

verze pro aktuáln¥ pouºívaný opera£ní systém. Následným kliknutím na polí£ko Down-

load se uloºí soubor. P°i spu²t¥ní instalace se povolí programu provedení zm¥n v tomto

15

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

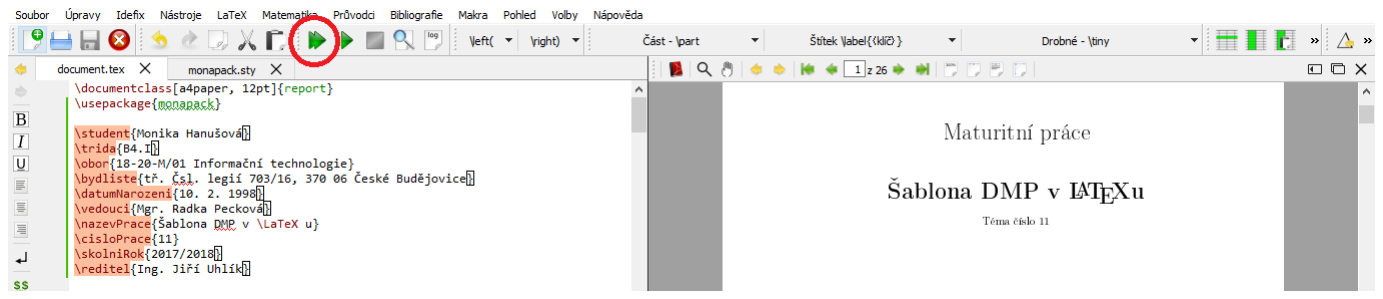
[picture p45: figure]

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

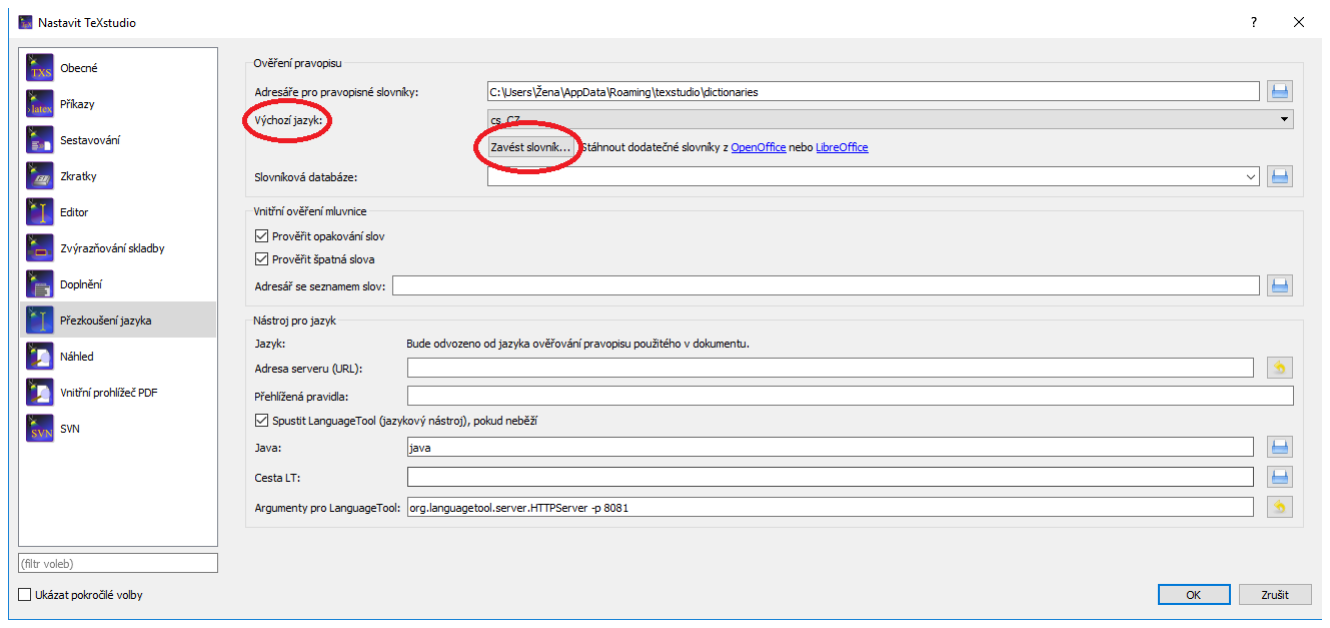
[picture p46: figure]

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

{práce je majetkem}{datum podepsání}.

Parametr 2 aº 4 jsou bodové seznamy, jeº se vytvo°í pomocí p°íkazu \bod a vloºením

textu bezprost°edn¥ za tento p°íkaz. Pokra£uje se stejným zp·sobem se v²emi body. Pátý

parametr dokon£uje v¥tu Náklady na materiál bude hradit. . . . Do parametru se vepí²e jedna z t¥chto variant: ²kola/rma/ºák. estý parametr dokon£uje v¥tu: Funk£ní vzorek

bude majetkem. . . . Do parametru se pouºije jedna z t¥chto variant: ²koly/rmy/ºáka.

Zadání je vytvo°eno i jako samostatný soubor LaTeX_task z d·vodu pot°eby samostat-

ného souboru jiº d°íve neº je psána samotná dokumentace. Po vytisknutí dokumentace je

vhodné vym¥nit £ást obsahující zadání za jiº potvrzené zadání.

## 4.3 Kapitoly a podkapitoly

K rozd¥lení textu do jednotlivých úrovní slouºí kapitoly a podkapitoly. Jsou p°ipraveny

celkem £ty°i úrovn¥, jeº lze vyuºít:

\kapitola{název kapitoly aneb nadpis 1. úrovn¥}

\podkapitola{název podkapitoly aneb nadpis 2. úrovn¥}

\podpodkapitola{název podpodkapitoly aneb nadpis 3. úrovn¥}

\podpodpodkapitola{název podpodpodkapitoly aneb nadpis 4. úrovn¥}

Praktický p°íklad:

\kapitola{Úvod}

\podkapitola{Téma}

\podpodkapitola{e²ení}

\podpodpodkapitola{Problematika}

Po vysázení: (viz. obr. 4.1)

21

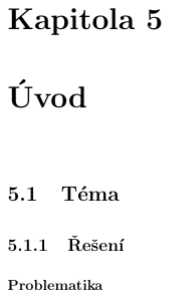
[picture p47: figure]

Obrázek 4.1: Kapitoly

## 4.4 Psaní textu

## 4.4.1 Ukon£ení odstavce

Pro ukon£ení odstavce je t°eba na konec textu p°idat dv¥ zp¥tná lomítka \\. Dal²í text

jiº bude umíst¥n na nové °ádce.

## 4.4.2 Nová strana

ablona sama rozmis´uje strany dle normy. Je-li pot°eba i tak vynutit novou stranu,

pouºije se následující p°íkaz \novastrana.

## 4.4.3 Ned¥litelná mezera

Na konci °ádku by se dle typograckých pravidel nem¥lo objevit jedno písmeno £i p°ed-

loºka. Pouºíváme proto ned¥litelnou mezeru. Ta se v sázecím prost°edí LATEX pí²e tildou

neboli vlnovkou ∼ (pravý alt + +).

22

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

grafický výstup na monitoru}

\polozka {procesor}{základní elektronická sou£ást, která umí vykonávat

strojové instrukce}

}

Po vysázení:

základní deska základní hardware v¥t²iny po£íta£·

gracká karta sou£ást po£íta£e, jejímº úkolem je vytvá°et gracký výstup na monitoru

procesor základní elektronická sou£ást, která umí vykonávat strojové instrukce

## 4.6 Stromová struktura

Pro tvorbu stromové struktury slouºí p°íkaz \strom{}. Kaºdá úrove¬ stromu se napí²e

do hranatých závorek a kaºdá dal²í se vno°í op¥t do hranatých závorek následujícím

zp·sobem:

\strom{

[1. úrove¬

[1.1 úrove¬]

[1.2 úrove¬

[1.2.1 úrove¬]

]

]

}

Praktický p°íklad:

\strom{

[Strom

[V¥tvi£ka]

[Líste£ek

26

[Zelený]

[Oranºový]

[lutý]

]

]

}

Po vysázení:

Strom

V¥tvi£ka | Líste£ek
Zelený | Oranºový | lutý

## 4.7 Tabulky

## 4.7.1 Klasická tabulka

P°íkaz:

\tab{nazevTabulky}{Popisek k tabulce}{|c|c|}{

\cara

prvek & prvek

\cara

prvek & prvek

\cara

}

Pro tvorbu libovolné tabulky se do prvního povinného parametru p°íkazu \tab vloºí

vlastní jedine£ný název tabulky. Pomocí tohoto názvu se bude moºno v textu odhazovat

na tabulku díky p°íkazu \viztab{nazevTabulky}, umíst¥nému bezprost°edn¥ do textu.

Druhý parametr ur£uje popisek, jeº se zobrazí pod tabulkou.

Do t°etího povinného parametru se vkládají následující hodnoty. Písmena c, r, l zná-

27

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

Dal²í moºnosti zápis·:

Odmocnina: \sqrt[n]{vzorec pod n-tou odmocninou}

Suma: \sum_{spodní index}ˆ{horní index}

Limita: \lim_{definovaní meze}{vzorec pro limitu}

Integrál: \int_odˆdo

Praktický p°íklad:

\vzorec{

1+2&=&3\\

B_{1}&=&\sum_{i=1}ˆN m_i \leva[ xˆi_2 \leva( \omega_1 xˆi_2 - \omega_2

xˆi_1 \prava) - xˆi_3 \leva( \omega_3 xˆi_1 - \omega_1 xˆi_3 \prava)

\prava]\\ }

Po vysázení:

1 + 2 = 3

B1 =

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
2 − ω2x

i
1
− x

i
3
ω3x

i
1 − ω1x

i
3

i

Dal²í funkce a symboly naleznete v p°ílohách.

## 4.10 P°ílohy

P°íkaz \prilohy vytvo°í p°ílohy ozna£ené písmeny dle abecedy. Do povinného parametru

se vkládají p°ílohy stejným zp·sobem, jakoby ²lo o kapitoly (viz 4.3 Kapitoly a podkapi-

toly).

\prilohy{

\kapitola{název p°ílohy1}

\kapitola{název p°ílohy2}

}

31

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

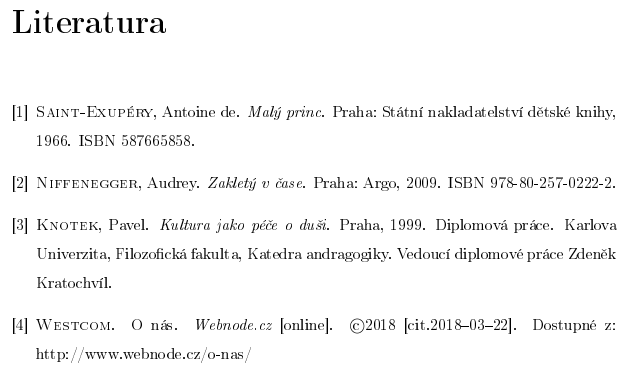
[picture p48: figure]

Obrázek 4.3: Literatura

Praktický p°íklad:

\literatura{

\kniha{princ}{Saint-Exupéry}{Antoine de}{Malý princ}{Praha}

{Státní nakladatelství d¥tské knihy}{1966}{587665858}

\kniha{zaklety}{Niffenegger}{Audrey}{Zakletý v £ase}{Praha}

{Argo}{2009}{978-80-257-0222-2}

\kvalifikacniprace{diplomka}{Knotek}{Pavel}{Kultura jako pé£e o du²i}

{Praha}{1999}{Diplomová práce}{Karlova Univerzita, Filozofická fakulta,

Katedra andragogiky}{Vedoucí diplomové práce Zden¥k Kratochvíl}

\url{adresa}{Westcom}{O nás}{Webnode.cz}{2018}{\dnes}

{http://www.webnode.cz/o-nas/}

}

Po vysázení: (viz. obr. 4.3)

33

# Kapitola 5

# Záv¥r

ablona DMP je ²ablona speciáln¥ pro psaní dokumentace maturitní práce v sázecím sys-

tému LATEX. Je ur£ena pro studenty SP a VO Písek. e²í typograi i esteti£nost a jejím

hlavním kladem je zjednodu²ení tvorby dokumentace k maturitní práci pro budoucí stu-

denty.

Hlavní sou£ástí práce je i p°ipojený dopl¬ující styl tzv. balík monapack. Tento styl je zdro-

jový text makrojazyka TEXu uloºený v souboru. Monapack p°ipojuje dal²í pot°ebné balíky

pro správné d¥lení slov, pro vstupní kódování textu UTF-8 (zahrnuje i £eská diakritická

písmena), pro výstupní kódování (nap°. ozna£ování slov v PDF výstupu nebo d¥lení slov

s diakritikou) a pro vkládání grackých obrázk·. Dále zahrnuje balík pro úpravu okraj·

stránky a zahrnuje i balík usnad¬ující zm¥ny styl· záhlaví sekcí a pozd¥ji denuje úpravu

styl· sekcí vhodn¥ vzhledem k okraj·m stránky.

Aby byl dodrºen správný vzhled normostrany, balík monapack redenuje p·vodní p°í-

kaz pro °ádkování a stanovuje ho na °ádkování 1,5. Obsahuje denici p°íkazu pro rychlé

a automatické vygenerování titulní strany, zadání, licen£ní smlouvy i p°íkazy pro tvorbu

pouºité literatury. Zahrnuje p°íkaz pro tvorbu stromové struktury a p°ipojuje i pot°ebný

balík.

V ²ablon¥ je nadenováno správné £íslování stran a to od první kapitoly aº po poslední

stránku. První strana, jeº je £íslovaná, je ozna£ena £íslem p°íslu²ným k p°edchozímu po£tu

stránek, tj. zahrnuje do po£tu titulní stranu, zadání, licen£ní smlouvu, anotaci, pod¥ko-

vání i obsah.

Nejpot°ebn¥j²í p°íkazy jsou p°ejmenovány do £eského jazyka pro snadn¥j²í a p°ív¥tiv¥j²í

ovladatelnost i pro studenty, kte°í neovládají angli£tinu £i nikdy nepracovali s ºádnou

distribucí TEXu. Jsou to nap°íklad p°íkazy pro formátování text·, pro generaci obsahu,

pro tvorbu seznam·, pro úpravu styl· textu, pro vkládání obrázk·, tabulek a referencí.

34

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

P°íkaz | Význam
\cislseznam{\bod text} | íslovaný seznam
\bodseznam{\bod text} | Ne£íslovaný seznam
\popisseznam{\polozka{tu£ný text} | Popisový seznam

{klasický text}}

\strom{} | Stromová struktura
\tab{nazevTabulky}{Popisek k tabulce} | Klasická tabulka

{|c|c|}{\cara prvek & prvek\\ \cara}

\tabulka{nazevTabulky}{Popisek k tabulce} Profesionální tabulka

{prvek & prvek\\}{prvek & prvek \\}

\viztab{nazevTabulky} | Odkaz na tabulku v textu
\obrazek{nazevObrazku}{popisek}{²í°ka} | Vloºení obrázku

{soubor}

\viz{nazevObrazku} | Odkaz na obrázek v textu
\vzorec{} | Matematický zápis i na více °ádk·
\zlomek{£itatel}{jmenovatel} | Zlomek
\matice{} | Matice
\sipka | ipka vpravo
\leva( | Automatická velikost levé závorky
\prava) | Automatická velikost pravé závorky
\text{text} | Vloºení textu do vzorce
\prilohy{\kapitola{P°íloha} \kapitola | Vytvo°í p°ílohy

{P°íloha 2}}

Tabulka A.3: Seznam p°íkaz· 2

40

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

# Literatura

[1] Pala, Karel. Úvod do systému LATEX. Praha: Edi£ní st°edisko VUT, Praha 6,

Zíkova 4, 1990. ISBN 80-01-00395-7.

[2] Bojko, Pavel. Problematika sazby odborného textu v prost°edí LATEX. eské Bud¥jo-

vice, 2011. Bakalá°ská práce. Jiho£eská univerzita v eských Bud¥jovicích, P°írodo-

v¥decká fakulta. Vedoucí bakalá°ské práce RNDr. Vít¥zslav Stra¬ák, Ph.D..

[3] MiKTEXorg. About MiKTEX. miktex.org [online].

c 2018 [cit.2018-02-28]. Do-

stupné z: https://miktex.org/about

[4] TEXstudio. Welcome to TEXstudio. texstudio.org [online].

c 2018 [cit.2018-03-01].

Dostupné z: https://www.texstudio.org/

44
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
