realWalter05/automated_chess/soc/Automatické šachy.pdf

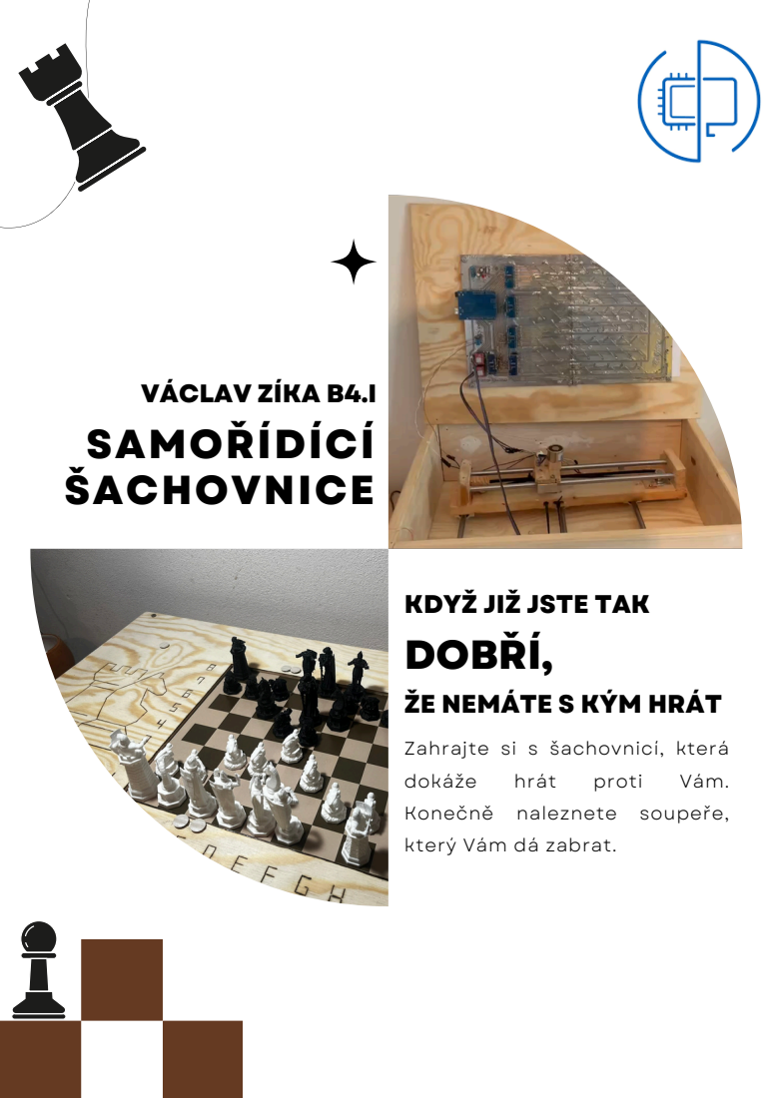
[picture p49: page 1]
SAMOŘÍDÍCÍ ŠACHOVNICE; dokáže; hrát; proti; Vám.; VÁCLAV ZÍKA B4.I

KDYŽ JIŽ JSTE TAK
DOBŘÍ,
ŽE NEMÁTE S KÝM HRÁT

Zahrajte si s šachovnicí, která
Konečně naleznete soupeře,
který Vám dá zabrat.
