realWalter05/automated_chess/soc/socPrilohy/A.1_schema_sachovnice.pdf

## Spínače obtížnosti

# Spínače pro šachovnici

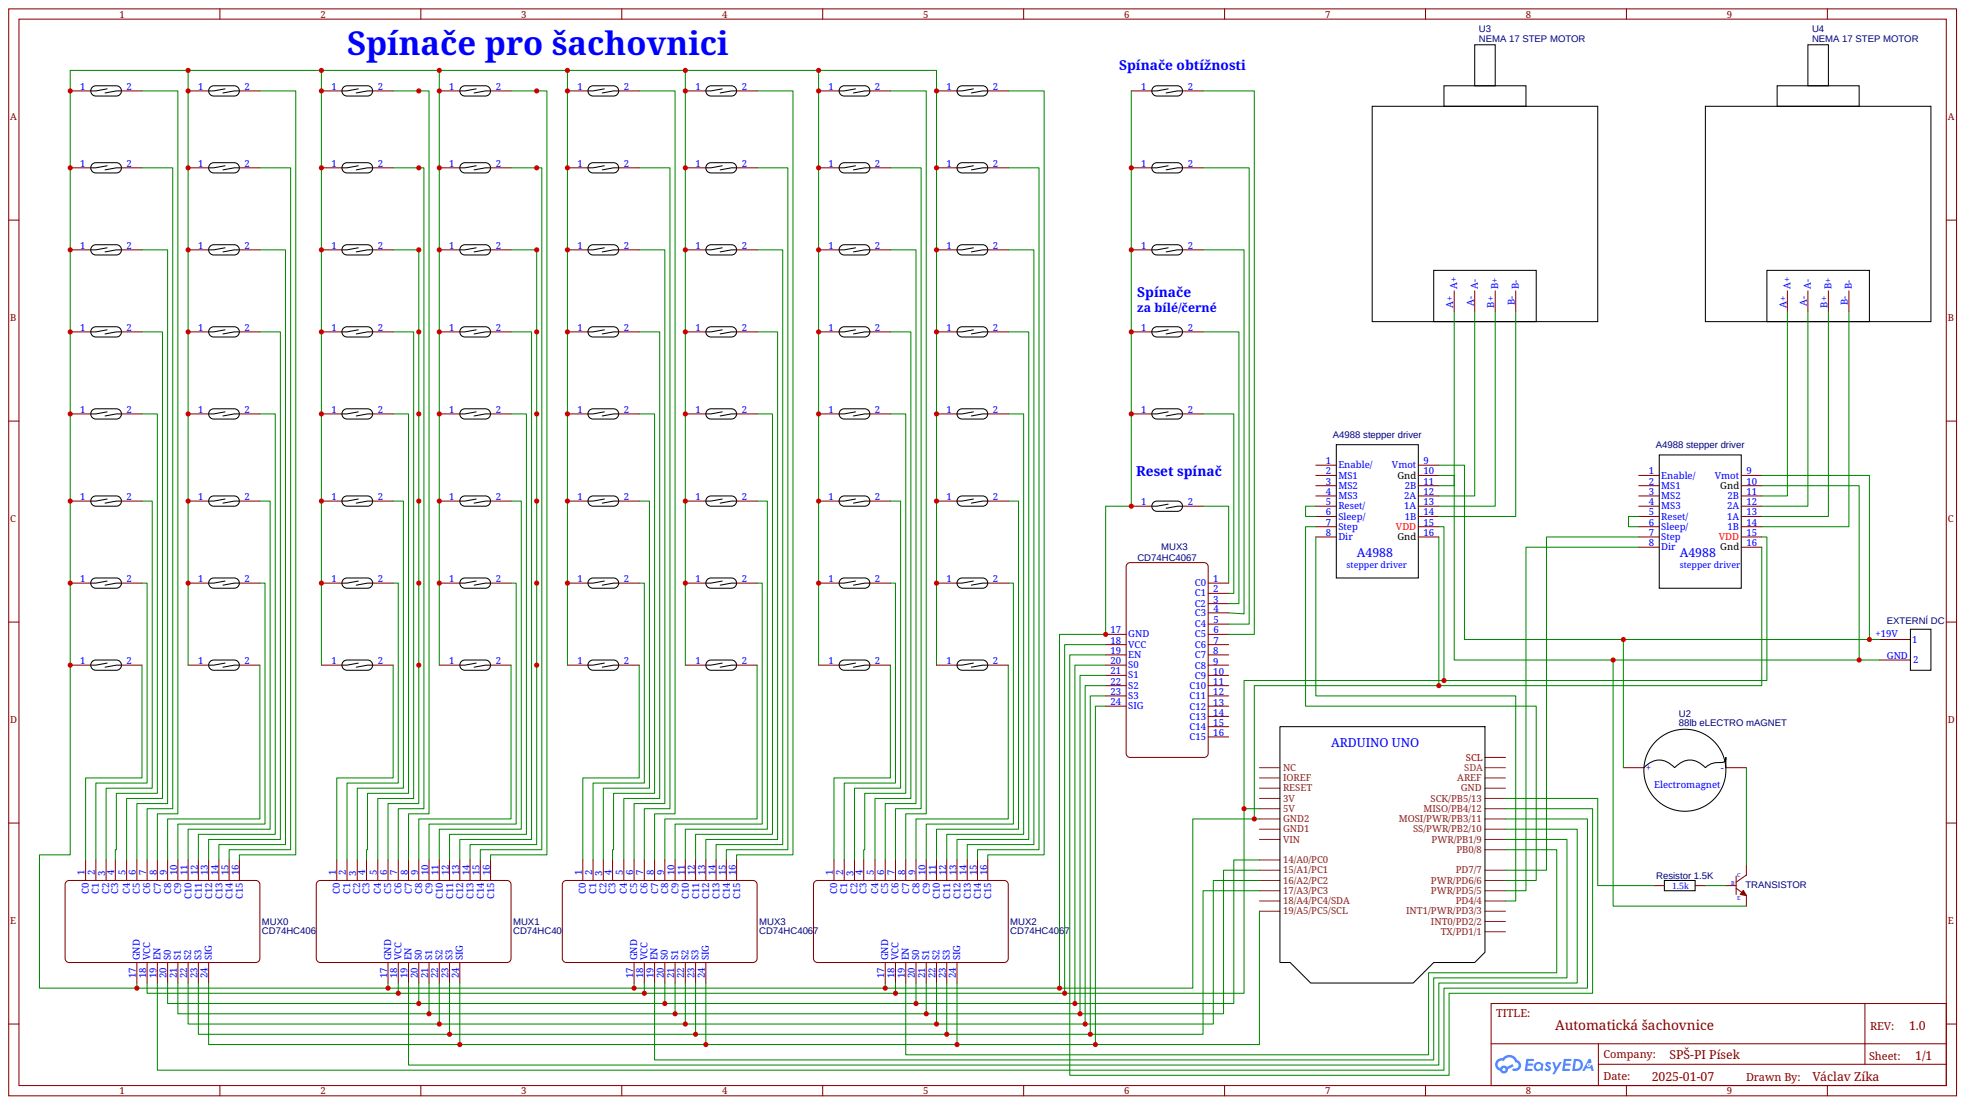
[picture p50: page 1]

Company: SPŠ-PI Písek

Drawn By: Václav Zíka
